manhkhiemhoang2-bit/xinmou-real-time-vision-tracking/mechanical/v10/V10_level_base_20261022/README_水平支撑说明.md

# 三轴云台 V10：桌面水平支撑修正

V9 装配中原项目留下的 battery holder 是 75 × 23 × 40 mm 的实心参考模型，已被标为“勿打印”。它在 V9 总装中低于桌面支撑面 12.625 mm，导致整机查看 STL 看起来由单独一块先接触桌面。V10 在原生 SolidWorks 总装中抑制此失效参考体，并重新导出整机查看 STL。

装齐底盖后，桌面接触面为底盖及左右两个后支脚，共三处。实际 STL 核对的最低高度均为 Z=25.000 mm；没有其他实体低于它们。底盖接触区约 71.8 × 60.8 mm，后脚各约 20 × 20 mm。三处可形成水平支撑；底盖不可省略。

7 种可打印 STL 共 10 件，与 V9 对应文件逐字节相同。已经打印 V9 的用户无需因本次修正重印。V10 修改的是总装中失效参考体的显示与整机预览。

外接电池和 HX1P35A 开发板未给出实测质量与最终安装点。等密度几何体积中心位于接触凸包内，距最近边约 58 mm；这仅是几何检查，不代表装入实物后的真实重心。装配后把底盖和两只后脚同时放在平整桌面上，检查摇晃；若打印面不平，修整三处接触面并复核电池位置。

保留 V9 的 MPU6050 双 M2 孔（中心距 16 mm、距俯仰平台前缘 10 mm）、走线孔及后部 HX1P35A 平台。
