manhkhiemhoang2-bit/xinmou-real-time-vision-tracking/hardware/td/ph1p35_isp/sim/_full6_check_判读说明.md

# `_full6_check.log` 判读说明（重要）

**看到日志末尾的 `结论：FAIL —— 1 条` 不要慌。RTL 没有问题，是 checker 的判据口径有瑕疵。**

## 那一条 FAIL 的真相

```
E M3的src行   断言 1,832,336   不符 34,306   FAIL
```

日志里紧挨着的两行已经把答案写明了：

```
反解 916168 个有效像素：多解/无解 34306，解出的行 != 期望行 0
候选 [彩色第 y-1 行（正确）]：不符        0 / 229042 拍   匹配（正确候选）
```

- **`解出的行 != 期望行 0`** —— 凡是能唯一反解出来的像素，**行号一个都没错**。
- 那 34,306 处全部是 **「多解/无解」**：测试图里有些像素值在相邻几行都出现，
  反解方法无法唯一确定它来自哪一行。**「猜不出来」不等于「猜错了」。**
- **正确候选（彩色第 y-1 行）0 失配 / 229,042 拍完美匹配**；
  另外三个错误候选（y 行、y-2 行、灰度行）全部 229,042 拍全错。
  ⇒ `rgb_row_delay_96` 在 320 深地址下工作**完全正确**。

首错那条 `(85880, 283, 270, 270)`：期望 270、实际也是 270，自己跟自己"不符"——就是这个毛病。

## 要改的地方（下次做）

E 组判据应把 **多解/无解记为 inconclusive**，只有「解出的行 != 期望行」才算 FAIL。改完即 PASS。

## 背景

这是**第三次**假警报来自 checker 而不是 RTL：
1. 「rgb_row_delay 每行丢最后 5 拍」→ checker 取样轴错位
2. 「TB 卡死」→ TB 消隐生成器死循环
3. 本条 → checker 把多解/无解当成错误

根源相同：这套全尺寸 checker 用「从数据反推期望值」的路子，
在规模大、数据有重复时容易产生歧义。**是验证工具的质量问题，不是设计问题。**
