manhkhiemhoang2-bit/xinmou-real-time-vision-tracking/hardware/td/ph1p35_isp/sim/_m7_report.md

# M7 区域填充接入 alg_top —— 集成报告（2026-09-18）

> 任务：把已验收的 `alg_region_fill_96`（v3.2）接成主流程第 8 档 **M7**，跑通集成回归。
> 本文是完整版；对话里给 ≤40 行的摘要。四个强制块在 ① / ② / ⑤ / ⑥。

---

## ① 结论一句话

M7 已接进 `alg_top` 三副本 + `.al`/`tcl` 登记，`check_sync.py` PASS；
小尺寸 **160×64 × 8 帧（f0..f7 = M0..M7）基线 355,753 条断言 0 失配**、
`vlog` **0 error 0 warning**、TB 自检 PASS；
**40 条真 RTL 变异全部被抓（含任务书点名的 5 类）**，无一条"dump 与基线相同"的空操作。
过程中实测定位到一个任务书没预料到的坑：**M3 的"窗口不可信拍"输出是未定义值，
填充模块的 3×3 膨胀会往左多吃一个像素把它吃进去**（1051 拍错位），
已在 M7 支路里用 `r_mask_d` 明确声明为黑并按同口径写进参考模型，失配归零。

---

## ② 证据路径

### 2.1 三副本 / 工程登记（`python check_sync.py` → VERDICT: PASS）

| 文件 | md5（三份相同） | 位置 |
|---|---|---|
| `alg_top.v` | `8bff2801fd77fc888c3332014023dbc6` | `src\` / `prj\_fullchip\alg\` / `prj\board\...\hdl_source\alg\` |
| `alg_region_fill_96.v` | `e3a92de0a23e5f3b25983b214a490511`（**未改动**，仍与验收时同 md5） | 同上三处 |

`.al` 新增 `alg/alg_region_fill_96.v`（CompileOrder 66，CRLF 保持：613 CRLF / 0 裸 LF）；
`prj\_fullchip\run_ab_alg.tcl` 的 `read_hdl` 清单加入 `alg/alg_region_fill_96.v`。
日志：`sim\_m7_check_sync.log`。落盘脚本：`sim\_m7_sync_files.py`（可重复执行）。

### 2.2 基线（`python run_m7_small.py` → rc=0）

* `vlog`：`Errors: 0, Warnings: 0`；`vsim` TB 自检 `in_beats=20480 out_beats=20480
  out_tlast=512 out_tuser=8 → RESULT=PASS`。
* dump：`sim\dump_m7_small.txt`（3,258,026 B = 31,434 拍）md5 `1106745dbc611a6ffad54aad3ec6f2e3`。
* 判据表（`sim\_m7_check.log`，**没有任何一条是 0 次检查**）：

| 判据 | 断言 | 不符 | 判据 | 断言 | 不符 |
|---|---|---|---|---|---|
| A 逐档延迟（M7=8） | 114,782 | 0 | F X/Z 泄漏 | 20,481 | 0 |
| B 八档逐拍对金标准 | 20,480 | 0 | J 每行/每帧拍数 | 61,444 | 0 |
| C 掩蔽区=原图（M7 除外，见 M③） | 3,977 | 0 | K M0 直通=LAT | 2,560 | 0 |
| D 档位锁存 | 20,488 | 0 | G bbox（按档选族） | 21 | 0 |
| E M3 的 src 行 | 19,344 | 0 | L M6 对齐/拍数/非空 | 5,124 | 0 |
| I 行/帧消隐工况 | 20,481 | 0 | **M M7 对齐/掩蔽/阈值/非空** | **5,129** | **0** |
| H 激励自检 | 61,442 | 0 | 合计 | **355,753** | **0** |

* M7 帧（f7，按键路径切进来的）：前景 **7,801 像素（76.2%）**、掩蔽区白 **0**、
  "阈值化 vs Sobel edge 掩码"不符 **0**、裸填充/带掩蔽填充差异 **177** ⇒ 判据 M 五门禁全非空。

### 2.3 变异（`python mutate_alg_top_full.py --size 160x64` → 40/40 PASS，244 s）

任务书点名的 5 类 + 本次定位到的坑，全部**实测 dump 与基线不同**（脚本逐字节比，无一条空操作）：

| 变异 | dump | 报红判据 | 结果 |
|---|---|---|---|
| M7 阈值 128→**255**（三字节全 0xFF，填不出东西） | 与基线不同 | B(2265) | 抓住 |
| M7 阈值 128→**8**（大片误判成白，近似全屏填满） | 与基线不同 | B(395) | 抓住 |
| M7 填充模块改吃**二值化支路** `w_b_dat`（实心图） | 与基线不同 | B(774) | 抓住 |
| M7 吃**未阈值化**的提亮彩图 `w_s_dat` | 与基线不同 | B(2265) | 抓住 |
| **按键循环上限只到 M6**（M7 永远切不到） | 与基线不同 | A(3074),**B(2560)**,**D(2560)**,M(194) | 抓住 |
| **输出 mux 漏掉 M7 一支**（回落 default 直通） | 与基线不同 | A(3074),**B(2560)**,M(194) | 抓住 |
| **档位常量 M7 写成 3'd6**（撞 MODE_MOTION） | 与基线不同 | A(3074),B(2560),**D(2560)**,M(194) | 抓住 |
| M7 输入不与 `r_mask_d` 相与（第 0 拍未定义值漏进膨胀） | 与基线不同 | B(1060) | 抓住 |
| 切进 M7 不提前 1 拍换档（边界多吐 1 拍） | 与基线不同 | A(3),B(1268),F(1),J(128),M(128),H(1) | 抓住 |
| M7 也叠顶层掩蔽（掩蔽区整体挪 3 拍） | 与基线不同 | B(257) | 抓住 |
| （原有 30 条 M5/M6/窗口/掩蔽/延迟…） | — | — | 30/30 抓住 |

改期望值那一半：`check_alg_top_full.py --selftest`（小尺寸）**28/28 抓住**（含 6 条 M7 口径变异）。
⚠ 其中 6 条 M7 口径变异带 `"_m7": True`，在**没有 M7 帧的 1280×720 时序里会被自动筛掉**
（不筛就是空操作 = 假"漏掉"，会让你的全尺寸 `--selftest` 变红）。

### 2.4 阈值选值的**实测**依据（`sim\_m7_thresh_probe.py`）

口径（三处写死同一份：`alg_top.v` §5d / `gen_stim_top_full.RF_TH` / 本报告）：
**白 ⟺ 三字节都 ≥ `RF_TH`（默认 128）**，其余一律黑。

| 几何 | 非边缘像素 min(R,G,B) 最大 | 边缘像素 min(R,G,B) 最小 | T=121..128 | T=8 | T=129 | T=255 |
|---|---|---|---|---|---|---|
| 160×64（帧 0..2） | 12 | 128 | **与 edge 掩码 0 失配** | 10,719 错 | 3,049 错 | 7,757 错（前景 0） |
| 1280×720（帧 0） | 120 | 128 | **0 失配**（163,777 前景） | — | 28,575 错 | 前景 0 |

* **128 = "不漏边缘"的最大阈值**：提亮后 `out_min = min(min(src)+K, 255) ≥ K = 128` 恒成立
  ⇒ 阈值 ≤ 128 时真边缘一个不漏；129 就漏 28,575 个。
* 非边缘像素 `out = src` 原样，实测 min 通道 ≤ 120 < 128 ⇒ 128 时不误判。
* 于是"三字节都 ≥ 128"在**本套激励**上逐像素等价于 Sobel edge 掩码（8 帧全部 0 失配，
  判据 M④ 每次跑都复验这一条）。
* `"三字节全 0xFF"`（254/255 口径）实测前景 **0** —— 这就是任务书说的"填不出东西"。

---

## ③ 集成的四处改动（都在 `alg_top.v`，M7 支路，未动任何已验收模块）

1. **档位**：`localparam MODE_REGIONFILL = 3'd7`；按键循环上限 `MODE_MOTION → MODE_REGIONFILL`；
   mux 加一支（数据+控制都取 `u_rf` 自己的）；`O_mode` 因此能出 7（判据 D：f7=[7]）。
2. **输入源**：`M3 的边缘流 → 硬阈值（`RF_TH`，见 2.4）→ u_rf`。
   阈值级是**纯组合**、不占延迟 ⇒ u_rf 的"延迟 3 拍"原样成立（累计 **4+3=7**）。
   输入还**与 `r_mask_d` 相与**（理由见 ④，这是本次唯一的非预期发现）。
3. **延迟**：M7 = **8 拍**（7 + 本级输出寄存器），M0..M6 仍是冻结的 5 拍。
   填充模块吃边缘、边缘只有 M3 那条支路有（已在延迟 4），4+3=7 是物理下限 —
   ⇒ M7 只能是"逐档延迟"，判据 A 因此改成**逐帧**判（M7 帧 8 拍、其余 5 拍）。
4. **掩蔽**：M7 档**不叠顶层掩蔽**（`w_masked_dat` 对 M7 直通）。
   两条理由：(a) u_rf 自带同口径掩蔽（前 3 行 + 每行第 0 拍）；(b) 顶层掩蔽对齐在延迟 4 拍，
   与 M7 的 7 拍不同拍，硬叠会把掩蔽区整体挪 3 拍（每行 12 像素）。
   ⇒ M7 帧掩蔽区输出**黑**，其余档位仍是"掩蔽期输出原图"。判据 M③ 单独钉死这条语义。

---

## ④ 本次唯一的非预期发现（已修，留作回归）

**现象**：接入后 M7 帧 1,051 拍不符，失配行恰好是 `8..15 / 24..31 / 40..47 / 56..63`。

**定位链**（四步，每步都有独立证据）：

1. 探针 TB（`sim\_m7dbg\tb_m7_probe.v`，**调试用，不进交付判据**）打出 u_rf 的输入流/膨胀/inside；
   `sim\_m7_probe_cmp.py` 按拍序对拍 → **填充模块的输入流本身就有 62 拍与参考不同**。
2. 62 拍全是**每行的第 0 拍**：RTL 给 `####`（4 个像素全算边缘），金标准给 `#...`。
   根因 = `alg_sobel_96` 的窗口在"窗口不可信拍"上**横跨行/帧边界**，输出的是**未定义值**；
   M3 档位上看不出来，因为顶层掩蔽在这些拍上把结果换成了原图。
3. 那 62 拍被填充模块自己的掩蔽挡住了（第 0 拍输出黑）——**但 3×3 膨胀会往左多吃一个像素**：
   第 1 拍（列 4..7）的膨胀窗口含列 3，正是第 0 拍的未定义值 ⇒ 每行第 4 列冒出一个假边缘
   ⇒ 填充的 inside 翻转位置整体错位 ⇒ 1,051 拍错。
4. 反证：把 **RTL 实测的输入流**（含那 62 拍）喂给参考填充模型 → 与 RTL 输出 **0/2560 拍不符**
   ⇒ 填充模块本身完全正确，问题 100% 在"喂进去的流没定义"。`sim\_m7_dbg_frame.py` /
   `_m7_dbg_inside.py` / `_m7_probe_cmp.py` 是这一段的证据脚本。

**修法**：M7 支路的阈值输出再与 `r_mask_d`（就是顶层那套、对齐在延迟 4 拍的窗口可信信号）相与，
把这些拍**明确声明为黑**；参考模型同口径（`m7_input_mask()`）。
**回归钉死**：变异 `M7 输入不与 r_mask_d 相与` → B(1060) 报红。

⚠ **另一条路（本次没走，留给你定）**：把 `win3x3_96` 在第 0 拍的左邻补零，
让 M3 流**处处有定义**（与金标准完全一致），那样 M7 支路就不需要这一层掩蔽。
代价是要动已验收模块 + 3 副本 + 它自己的判据；本次按"最小改动、不碰已验收模块"处理。

---

## ⑤ 不确定 / 没验证 / 觉得可疑

1. **没跑 1280×720**（按任务书 §五.3）。所以"M7 在真实分辨率下也对"**没有被本轮的集成仿真验证**；
   已验证的是 (a) 填充模块自己在 1280×720×3 帧上 0 失配，(b) 本轮的接口/对齐/掩蔽/阈值口径。
   ⚠ 有一处**只在小尺寸验过、全尺寸没验**：进 M7 时提前 1 拍换档依赖"帧首前 ≥3 拍无有效数据"
   （本链路帧消隐 120 拍，行消隐 20 拍）。判据 I 把这条工况钉死在激励里，但**换别的激励要复核**。
2. **M3 第 0 拍/前 2 行的输出是未定义值**这件事，我是用"探针 + 参考对照"定的，
   没有翻官方例程确认；我把它当"接口未定义"处理（声明为黑），
   而不是"RTL 错了"——依据是模块契约里这些拍本来就标着"窗口不可信"。
3. **判据 A/B/C/J 都改成"逐档"了**：A 用逐拍延迟表、C 把 M7 帧排除（改由判据 M 覆盖）、
   L/M 的"输出拍位置"改成按帧比。这是**口径扩展不是放宽**（每条仍逐像素/逐拍要求相等，
   而且新增了 6 条 M7 口径的期望值变异与 11 条 RTL 变异来钉）。但确实是本项目的判据结构变动，
   请你复核：特别是 `check_a` 的 `lat_of_beat()` 与 `check_c` 里 `~is7` 这两处。
4. **`ref_region_fill` 的 `barrier_mask` 是 2 行**（win3x3 口径），而填充模块内部是 `r_y>=3`。
   两者在 shift1 之后等价是模块验收时的实测结论，本轮**沿用了这个结论**（前 8 行实测吻合）；
   我没有重新推导它。
5. **TD 综合/面积没跑**（任务书禁止）。新增资源粗估：12 个 8 bit 比较器 + 1 个 AND（阈值级）
   + u_rf 自身（文档记 2 块 ERAM）。ERAM 预算 45/108 → 约 47。
6. **`sim\_m7dbg\` 下带 DUT 内部探针的 TB 只是调试件**，交付判据（`tb_alg_top_full.v` + checker）
   一个 DUT 内部量都没读 —— 抗循环论证纪律没破。
7. **小尺寸激励的档位表被改了**（见 ⑥.5），"7 帧跑"的老命令会退化成 f7 也是 M7 而不是 M6；
   若你要复跑旧的 M6 结论，请用 `--frames 7`（帧 0..6 仍是 M0..M6，f7 只影响第 8 帧）。

---

## ⑥ 与任务书不符 / 我认为任务书写错了的地方

1. **"加一级硬阈值就行"不够**：阈值之外**还必须**用窗口可信信号挡住未定义拍（见 ④）。
   任务书假设"M3 的信号要么是纯二值、要么是提亮图，二值化即可"，
   实际还有第三种情况：**窗口不可信拍上 M3 输出的是未定义值**，而填充的膨胀会跨拍吃它。
   这一条如果你只按任务书做，会得到 1,051 拍错且极难定位（失配行还是周期性出现的）。
2. **"M7 的输出比 M0/M1 晚（行位移 + 3 拍）"里的"行位移"要分开算**：
   相对**原图**，M7 一共下移 **2 行**（M3 自己的 1 行 + 填充模块契约的 1 行），
   相对 **M0/M1 的输出帧**才是 1 行；拍延迟才是 +3。任务书把两者写在一起，
   按字面理解会做成"shift1"而不是"shift2"（本报告的判据都用 shift2 = `_shift1` 两次）。
3. **"模块内部已经做了掩蔽（3 行 + 每行第 0 拍），所以 alg_top 里这一档不要再叠行掩蔽"**：
   我按"**M7 档整条顶层掩蔽都跳过**"实现（掩蔽区输出黑，不是原图）。
   如果你的本意只是"不要再往 u_rf 的输入上叠掩蔽"（保留顶层"掩蔽期输出原图"），
   那就需要再补一条延迟 7 拍的原图通路 + 一条延迟 7 拍的掩蔽（96×3 DFF + 3 DFF），
   并且掩蔽语义会和别的档位一致 —— 但**任务书这句话字面上是让我跳过**，我按字面做了。
4. **档位编号与项目文档冲突**：`doc_describe\分层实施计划_20260917.md` 与
   `osd_mixer.v` 第 5 节的注释都写 **M7 = 直方图均衡（HISTEQ）**，任务书把 M7 给了区域填充。
   OSD 只显示 "M7" 两个字符，硬件上不冲突；但**文档/注释现在与 RTL 不一致**，建议你统一。
5. **任务书点名要抓的变异"按键循环上限只到 M6"在小尺寸里原本是抓不到的**：
   旧的小尺寸档位表 `I_mode_set=1` 恒 1、逐帧强制指定档位 ⇒ **按键路径根本没被激励**，
   这条变异会是"dump 与基线逐字节相同"的空操作（= 无效变异）。
   我把小尺寸的**第 8 帧改成走按键路径**（前 7 帧仍用 `I_mode_sel`，帧 6 内按 7 下键 ⇒
   `r_mode_hold=7`）。这样才能真正抓到它（实测 B/D 各 2560 报红）。
   这是对测试框架的**语义扩展**，任务书没提，我按"变异必须可抓"的目标做了。
6. **`_shift1()` 只对"过窗口"的档位成立**：M5（颜色检测）与 M6（帧差）都没有整体位移，
   M7 是**两次** `_shift1`。任务书说"M2/M3/M4 都这么比"是对的，但别把它推广到全部档位。
7. **"全尺寸由我统一跑"的提醒**：你那套 12 帧时序里没有 M7 帧，所以
   (a) 判据 **M 与 L 都会是 0 次检查**（两条都会打警告说明覆盖在小尺寸；
   `L` 在本次改动之前就已经是 0 次，不是新问题）；
   (b) 若你要在 1280×720 下验证 M7，需要给那套表加一帧 M7（改 `MODE_SCHED` 与 TB 的档位表，
   两者必须同改，否则判据 D 会报）。
8. `run_full_algtop.ps1` / `run_l1_full.ps1` / `run_bubble.ps1` / `run_all_alg_top.ps1` 的
   编译清单都已加上 `alg_region_fill_96.v` —— **不加的话你的全尺寸跑会直接编译失败**
   （TB 例化了 alg_top，alg_top 例化了 u_rf）。
