manhkhiemhoang2-bit/xinmou-real-time-vision-tracking/hardware/td/ph1p35_isp/sim/_rf_report.md

# 区域填充（alg_region_fill_96）验证报告 —— **FAIL，未通过**

> 一句话：控制路径全绿、算法规则已按你的要求改对，但**逐像素比对仍然失败**
> （小尺寸 8 帧 2560 像素中 311 个失配）。**我没有交付一个可判 PASS 的模块**，
> 下面是完整、可复现的现状与我修掉的每一个真 bug。

---

## ① 结论一句话

`src\alg_region_fill_96.v` 的**接口/延迟/拍数守恒/值域全部正确**（TB 契约断言 4 项全 0 错），
你要求的两条算法改动（**上升沿判据**、**只吃轮廓图**）已实现并与 Python 参考写死同口径；
但**逐像素比对 FAIL**（311/2560 失配），根因是行缓存窗口抽头/行尾复位的时序，**未收敛**。

## ② 证据路径与实测数据

| 项 | 文件 | 状态 |
|---|---|---|
| RTL | `src\alg_region_fill_96.v` | v3.1，vlog **0 error / 0 warning** |
| 小尺寸 TB | `sim\tb_region_fill.v` | **TB-RESULT: PASS** |
| 真实分辨率 TB | `sim\tb_region_fill_hd.v` | 已同步 LAT=3，**本轮未重跑**（见 ④） |
| Python 参考 | `sim\ref_region_fill.py` | 上升沿判据已同步；`--selftest` **33 检查 0 错** |
| 判据 | `sim\check_region_fill.py` | **FAIL** |
| 激励 | `sim\gen_stim_region_fill.py` | 8 帧小图（含 2px/4px 承重用例）+ 3 帧 1280×720 |
| 几何探针 | `sim\tb_probe_win.v` + `sim\_probe_win_gen.py` | 用它**定死**了抽头是规整 3×3（Δy=−2/−1/0） |

### 小尺寸轮（32×10，8 帧，640 拍，含气泡）

| 断言 | 检查次数 | 失配 | 说明 |
|---|---|---|---|
| A10 输入回读一致 | 2561 | 0 | TB 实发序列 == stim 文件 |
| A1 拍数守恒 | 1 | 0 | 输入 640 / 输出 640 |
| A2 延迟 3 拍 | 705 | 0 | 实测 3 拍，逐拍平移 0 失配 |
| A3 tlast | 705 | 115 | 判据写法问题，见 ④.1 |
| A4 tuser | 705 | 16 | 同上 |
| A11 行结构 | 80 | 6 | 同上 |
| A8 输出值合法 | 2560 | 0 | 只有 FFFFFF/000000 |
| **A5 逐像素** | 2560 | **311** | **未过** |
| A6 逐帧+护栏 | 16 | 7 | 未过 |
| A7 掩蔽纪律 | 24 | 0 | 掩蔽区全黑；掩蔽确实改变 253 像素 |
| A9 内部填充电平 | 640 | 163 | 未过 |

TB 自带独立契约断言：`lat_err=0 last_err=0 user_err=0 valid_err=0 xz_or_illegal=0`，
`in_vld=640 == out_vld=640`。

## ③ 本次修掉的**真 bug**（都留了实测症状）

1. **`O_tdata` 根本没接填充结果**（接了 `r_src2` = 原样输入）。症状：A2/A8 照样全绿，
   只有逐像素比对暴露。修后失配 574 → 225。**这是"别只数拍数"的又一实例。**
2. **行尾状态复位早了一拍**：`r_tlast` 在行末拍**末尾**才装载，直接用它清零会把行末那拍
   自己的填充算成 0 ⇒ 每行**最右 4 个像素填不上**（实测：DUT 行 2 是 5..28，参考是 5..31，
   正好少最后 3 个）。修法：清零条件再打一拍（`r_clr`）。
3. **TB 自己的仿真竞争**：延迟断言写在 posedge 块里会拿"旧 O_*"比"新移位链"，误报 FAIL。
   改成 **negedge 比较**（必须在报告里留档，避免重踩）。
4. **`r_word` 被两个 always 重复驱动**、`r_pix0d` 因此悬空（改注释时留下的重复块）。
5. **左邻居必须走独立位移链**：本模块只存 4 bit/拍，读出链上取不到"第 r_x−1 组"，
   win3x3_96 那种"从 32bit 字节内部取左邻居"在这里不成立。

### 上升沿判据（你这次要求的改动）—— 已实现且有承重证据

- RTL §12/§13：`rise = e & ~prev`，4 级串行链，`prev` 与 `inside` 共用同一个清零分支。
- Python 参考已同步，注释写清"为什么不用奇偶规则"。
- **承重证据（Python 实测）**：2 像素宽闭合矩形，新规则填 **260** 像素、旧规则只填 **192**
  （内部空）⇒ 该用例确实能抓住"退回逐像素翻转"这条变异。

## ④ 不确定 / 没验证 / 觉得可疑（必读）

1. **A3/A4/A11 的失配我判断是判据写法问题、不是 RTL 问题**：TB 用独立 3 级移位链逐拍比对
   tlast/tuser **全 0 错**，而 Python 判据用的是"按有效拍平移 3 拍"的近似，与带气泡的实际拍距
   不一致。**但我没有把它改成 0 就被叫停，属于未验证。**
2. **A5 剩余的 311 个失配我没定位到根因。** 已知形貌（帧 0 逐行打印）：
   - **每行最右 4 个像素少填**：`y2 ref 5..31` / `dut 5..28`（行末那拍的填充被截断）；
   - **被掩蔽的第 0 拍反被填白**：`dut` 每行都是 `####.` 开头（列 0..3 白、列 4 黑），
     而参考是 `.....`（列 0..4 全黑）——**掩蔽区被填了**，说明 `w_fill*` 在 `w_win_valid=0`
     时仍有非零路径。这两条是同一个"行首/行尾 inside 边界"问题的两端。
   我修到"行末复位晚一拍"（`r_clr`）就停了，**没有再做第 5 次猜测式修改** ——
   按你的要求，下一步应该用逐拍探针表把 `e/rise/inside/r_clr` 与 Python 参考逐拍对齐，
   而不是继续改 RTL 猜。
3. **行位移约定：我用实测否掉了"整体晚一行"**：按"参考整体下移一行"比时失配 225→389（更差），
   而且 8 帧里只有 1 帧在"位移 0"下对得上。**所以至少对本模块，"win3x3_96 那样晚一行"不成立**
   （因为底行抽头取的是**本拍**输入）。这一条与你的建议相反，依据是实测数字。
4. **真实分辨率轮（1280×720×3 帧）本轮没重跑**；`dump_rf_hd.txt` 是旧 RTL 的产物，
   **不能作为 v3.1 的证据**。旧版本曾跑通 TB 契约（691200 拍，lat_err=0，9 秒）。
5. **没有变异测试脚本。** ≥5 个变异（含"退回逐像素翻转"）**一个都没做** —— 这是本轮最大的缺口。
6. **没跑 TD 综合**，`#eram` / `#dram lut` **未知**（按规则做了 1 bit/像素 + 读地址位宽对齐，
   但没有实测数字）。
7. **可疑**：`r_src2` 现在成了死寄存器（只写不读），综合会删掉；不影响功能，但应清理。

## ⑤ 与你给我的任务书不符 / 我觉得你写错了的地方

1. **"照抄 win3x3_96 的读地址领先 1 拍"在本模块不能照抄**：它每拍存 32 bit，左邻居能从
   读出数据的字节内部取；本模块为省 ERAM 只存 4 bit/拍，**链上取不到**第 r_x−1 组。
2. **"2 像素用例：改规则前必须失败"这一半我留了证据，"改完必须过"这一半没做到** ——
   因为行尾时序还有 bug（④.2），与上升沿规则无关。
3. **"行错位是既有约定、照 (A) 处理"这条我用实测否掉了**（④.3）。
4. **"至少一轮 1280×720"这条本轮没满足**（④.4）。
5. 我没有为了让判据变绿而放宽任何期望 —— 报告的就是 FAIL。

## ⑥ 第 5 次尝试（按你的判断做）—— **没做成，按约定停手，不再来第 6 次**

你的判断我复核了：**方向对**（这两端确实是"inside 属于哪一行"这一个问题）。
我按你说的做了**不改 RTL、先在模型里验**（`sim\_probe_inside.py`）：

```
clr_mode=tlast     -> 与 RTL dump 失配 278 拍
clr_mode=tlast_d   -> 与 RTL dump 失配 272 拍
clr_mode=rowstart  -> 与 RTL dump 失配 278 拍      ← 你建议的几何计数器口径
rowstart 模式 vs Python 参考：166/640 拍失配
   首错 cyc=18 r_x=1 r_y=2 e=[1,1,1,1] rise=[1,0,0,0] inside_in=0
        got=####   ref=....
```

**为什么停手**：三种清零口径的失配数几乎一样（272~278）⇒ **主要误差不在清零口径上**。
而且我随后发现**模型本身有一个未修正的拍号偏移**：

> 模型里 `r_x` 在 cycle 18 已经是 1（第 2 行第 1 拍），而真 dump 在 cycle 18 处理的是
> **第 2 行第 0 拍** ⇒ 模型的 `r_x` 比 RTL **早一拍**。所以上表里"e=1111 vs ref=0000"
> 这类差异**有一部分是模型自己对不齐造成的，不能直接当成 RTL 的错**。

在这种前提下继续按模型结论改 RTL，就是第 6 次猜测式修改，按你的约定我不做。
**下面是你要的逐拍表**（模型输出，前 2 行 × 前 16 拍；列：cyc / r_x / r_y / e / rise / inside_in / fill）：

```
cyc r_x r_y  e     rise   inside_in  fill
  8   0   0  0000  0000   0          0000    <- 被掩蔽 (r_y<2)
  9   1   0  0000  0000   0          0000
 10   2   0  0000  0000   0          0000
 11   3   0  0000  0000   0          0000
 12   4   0  0000  0000   0          0000
 13   5   0  0000  0000   0          0000
 14   6   0  0000  0000   0          0000
 15   7   0  0000  0000   0          0000    <- 行末
 16   0   1  0000  0000   0          0000    <- 新行首拍
 17   1   1  0000  0000   0          0000
 18   1   2  1111  1000   0          1111    <- 模型已进第 2 行；RTL 同拍仍是第 2 行第 0 拍
 19   2   2  1111  0000   1          1111
 20   3   2  1111  0000   1          1111
 21   4   2  1111  0000   1          1111
 22   5   2  1111  0000   1          1111
 23   6   2  1111  0000   1          1111
```

**建议的下一步**（我不做，交给你定）：先把 `_probe_inside.py` 的 `r_x`/`x_grp` 对齐到 RTL
（锚点：真 dump 里第 2 行第 0 拍出现在 cycle 18），**模型与 RTL 逐拍 0 失配之后**再用它比参考 ——
否则模型给出的"与参考的差异"里混着模型自己的偏移。

---

## ⑦ 集成结论（可执行：两条 + 一条补充）

1. **只能吃轮廓图**：输入必须是边缘检测（Sobel）的输出。**绝不能接二值化的实心色块** ——
   实心图每行只有"整段白"，上升沿只在段首出现一次，`inside` 会从段首一路保持到行尾，整幅花掉。
2. **模块内不做任何阈值**：输入期望**纯二值**（每像素恰好 `24'hFFFFFF` 或 `24'h000000`）。
   **这个硬阈值由你在 `alg_top` 里定，我不替它定**；本模块只认"三字节全 0xFF = 白"。
3. 模块**不反压**（`O_tready = I_tready`）、**单时钟域**、无 DSP/乘法器/除法器/DDR/厂商 IP。

---

## ⑧ 本轮**没做**的事（缺口的显式清单）

- ❌ 变异测试（≥5 个，含"退回逐像素翻转""去掉行首清零"两条护栏）——**一个都没做**
- ❌ 真实 1280×720×3 帧轮（`dump_rf_hd.txt` 是旧 RTL 产物，不可当证据）
- ❌ TD 综合实测 `#eram` / `#dram lut`
- ❌ 小尺寸逐像素 0 失配（当前 311/2560）
