manhkhiemhoang2-bit/xinmou-real-time-vision-tracking/docs/交付范围.md

# 交付范围与版本依据

- TD：当前 ph1p35_isp 工程的板级 RTL、IP 源与配置、约束、LUT/ROM 初始化文件、公共源码、模块仿真和生成脚本。
- FD：当前 FDWork 中的 yuntai_mcu 应用与 MCU_fpga 配套平台，保留 BSP、驱动、链接脚本和工程配置。
- 机械：用户指定的 V10 原生总装目录完整复制，包含 1 个装配、12 个零件及原有预览、说明和许可。
- 实现结果：活动 syn_1 / phy_1 的已有烧录文件、资源与时序报告；MCU 已有编译产物单列保存。
- 验证：报告图 5 / 图 7 对应的 ModelSim 测试源码、脚本和已有波形。

未纳入：历史 bak 备份、TD 旧 R1-R6 下载目录、综合布局布线数据库、IDE 工作区缓存、重复仿真工作库、视频和个人提交表单。这些不属于本次工程复现所需输入。

TD / FD 工程原有绝对目录由 tools/prepare_workspace.py 在解压或克隆后更新；逻辑源码、固件算法、机械文件和烧录文件保持原内容。三个大型仿真激励经 gzip 无损压缩保存。

机械目录的原有 MANIFEST_SHA256.json 中，总装 SLDASM 的旧校验值与当前文件不同，其余条目相符。本次保留用户指定目录当前的总装文件和原始清单，总装当前校验值由仓库根目录 MANIFEST_SHA256.json 记录。仅根据校验值不能判断总装的修改原因，本次未重保存或修改 CAD 文件。
