manhkhiemhoang2-bit/xinmou-real-time-vision-tracking/mechanical/v10/V10_level_base_20261022/V10_支撑面俯视核对.png

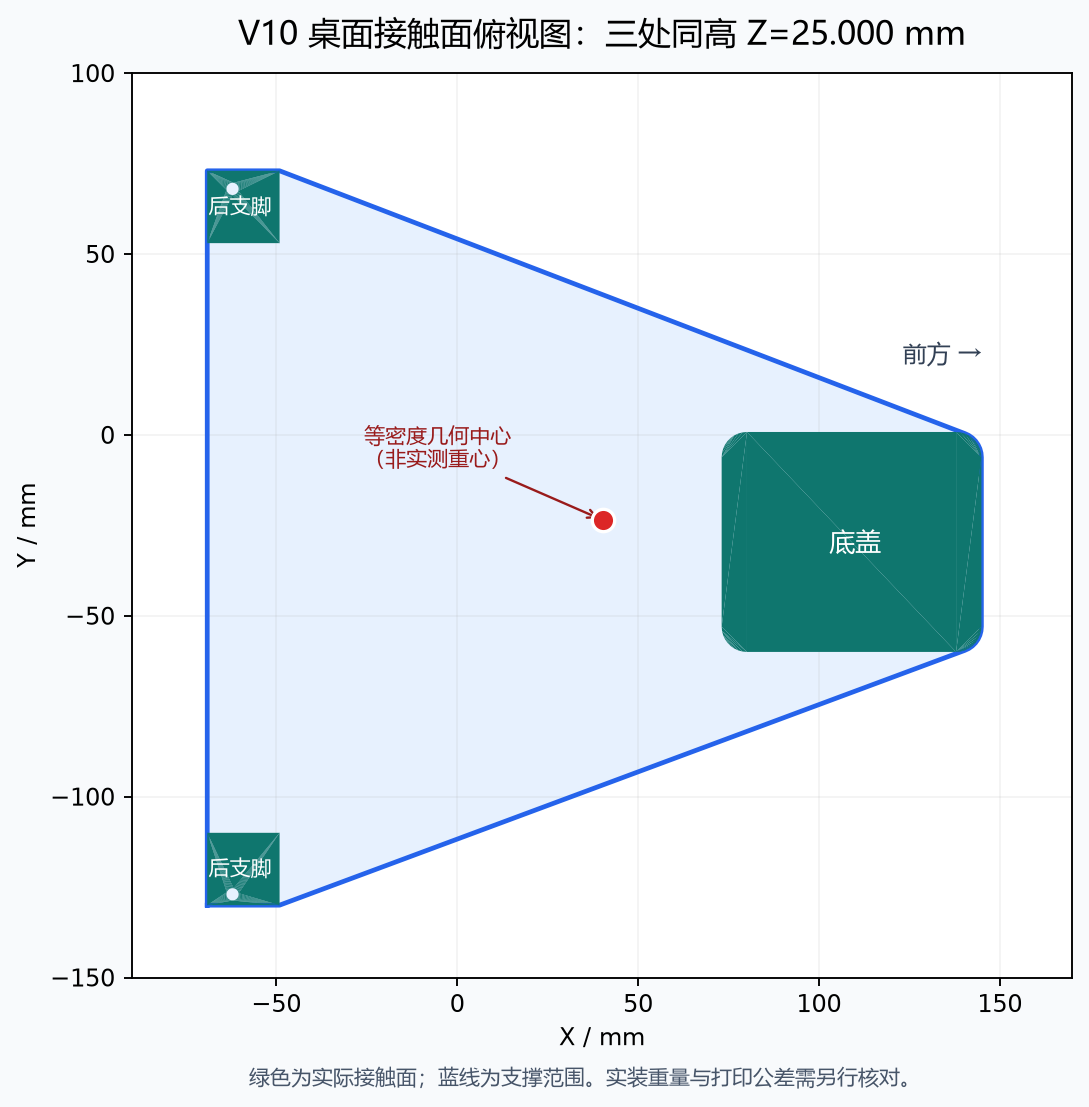
mechanical/v10/V10_level_base_20261022/V10_支撑面俯视核对.png
