manhkhiemhoang2-bit/xinmou-real-time-vision-tracking/mechanical/v10/V10_level_base_20261022/V10_V9_V5_V4_V3_V2_V1_Three_axis_gimbal.SLDASM

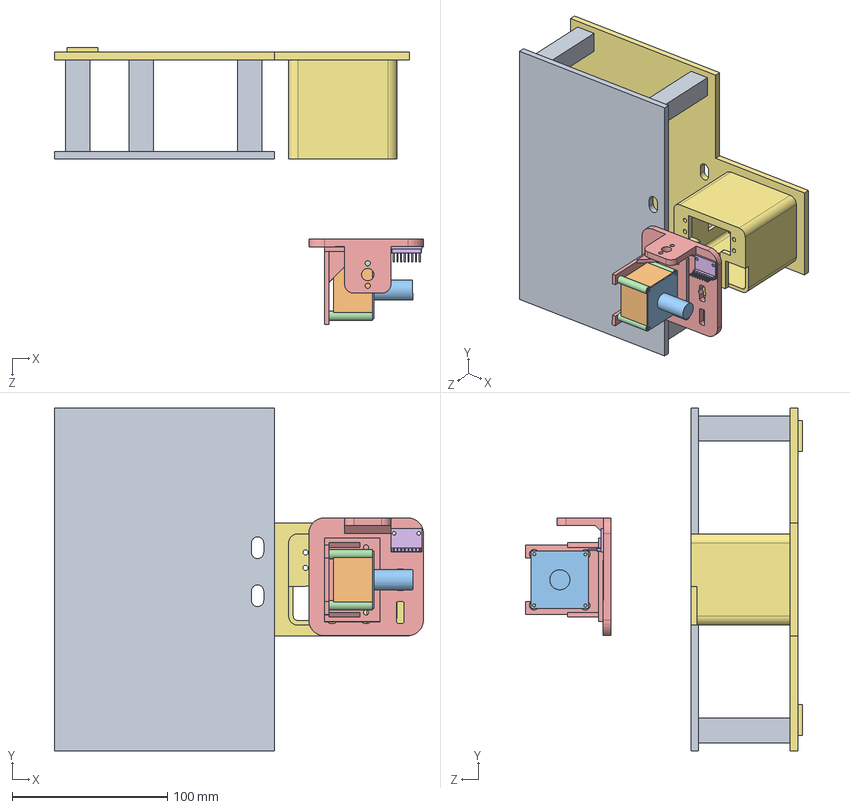
[picture p3: CAD file, 2026-11-03]
mechanical/v10/V10_level_base_20261022/V10_V9_V5_V4_V3_V2_V1_Three_axis_gimbal.SLDASM
238.0 x 221.0 x 178.7 mm
V10_V9_V5_V4_V3_V2_V1_Base 01 - Yaw servo
V10_V9_V5_V4_V3_V2_V1_MPU6050 model
V10_V9_V5_V4_V3_V2_V1_Top platform
V10_V9_V5_V4_V3_V2_Camera_spacer_28mm x 4
V10_V9_V5_V4_V3_V2_Camera_SC500CS_reference
V10_V9_V5_V4_V3_V2_Camera_rear25mm_reference
V10_V9_V5_V4_Rear_electronics_raised_deck
