manhkhiemhoang2-bit/xinmou-real-time-vision-tracking/mechanical/v10/V10_level_base_20261022/V10_V9_V5_V4_V3_V2_Camera_spacer_28mm.SLDPRT

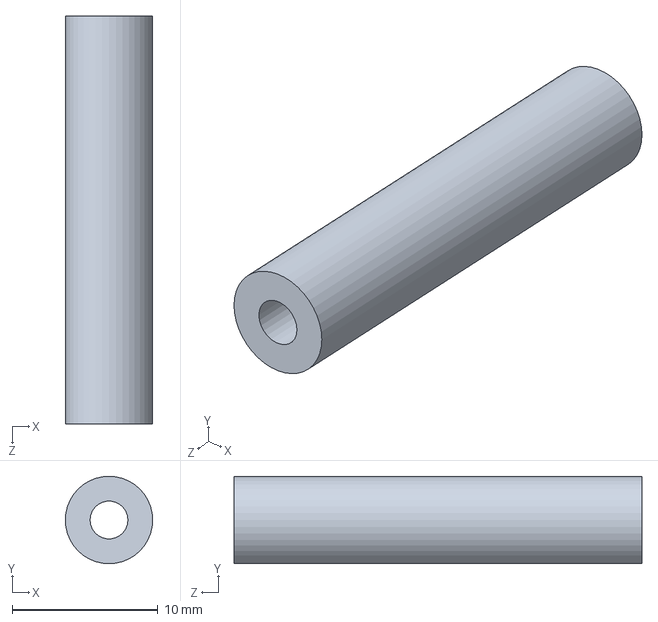
[picture p4: CAD file, 2026-11-03]
mechanical/v10/V10_level_base_20261022/V10_V9_V5_V4_V3_V2_Camera_spacer_28mm.SLDPRT
6.00 x 6.00 x 28.0 mm
