manhkhiemhoang2-bit/xinmou-real-time-vision-tracking/mechanical/v10/V10_level_base_20261022/V10_V9_V5_V4_V3_V2_Camera_SC500CS_reference.SLDPRT

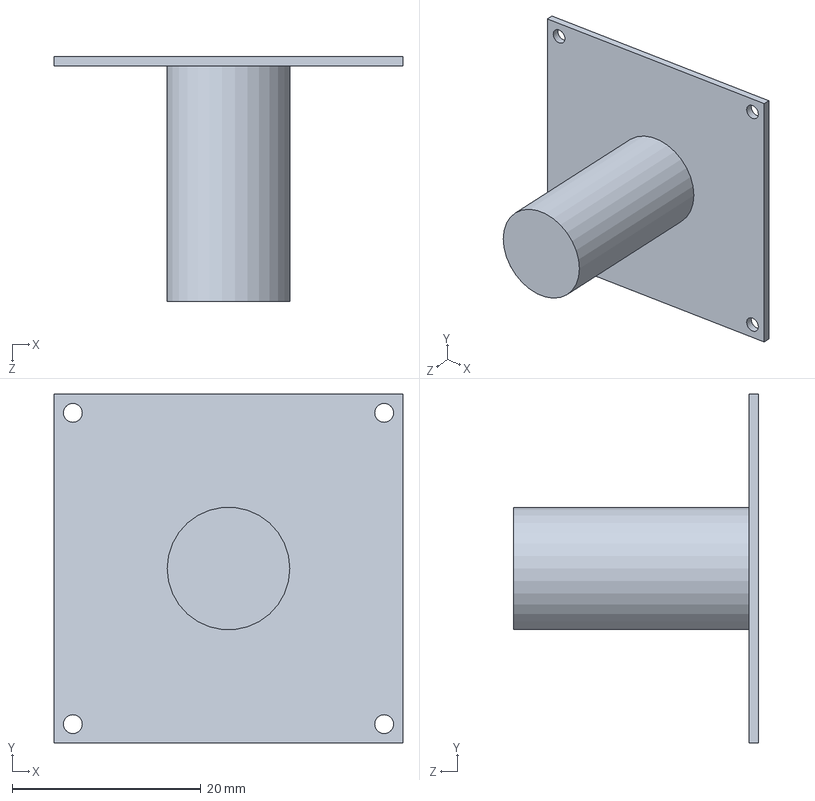
[picture p5: CAD file, 2026-11-03]
mechanical/v10/V10_level_base_20261022/V10_V9_V5_V4_V3_V2_Camera_SC500CS_reference.SLDPRT
37.0 x 37.0 x 26.0 mm
