manhkhiemhoang2-bit/xinmou-real-time-vision-tracking/mechanical/v10/V10_level_base_20261022/V10_V9_V5_V4_V3_V2_V1_MPU6050 model.SLDPRT

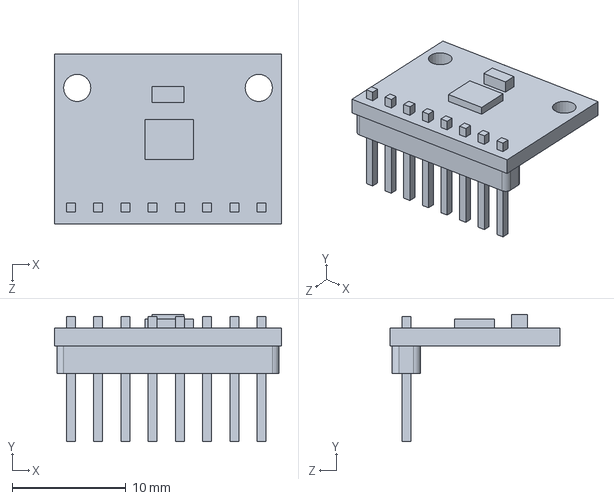
[picture p6: CAD file, 2026-11-03]
mechanical/v10/V10_level_base_20261022/V10_V9_V5_V4_V3_V2_V1_MPU6050 model.SLDPRT
20.0 x 11.2 x 15.0 mm
