manhkhiemhoang2-bit/xinmou-real-time-vision-tracking/mechanical/v10/V10_level_base_20261022/V10_V9_V5_V4_V3_V2_V1_Base 01 - Yaw servo.SLDPRT

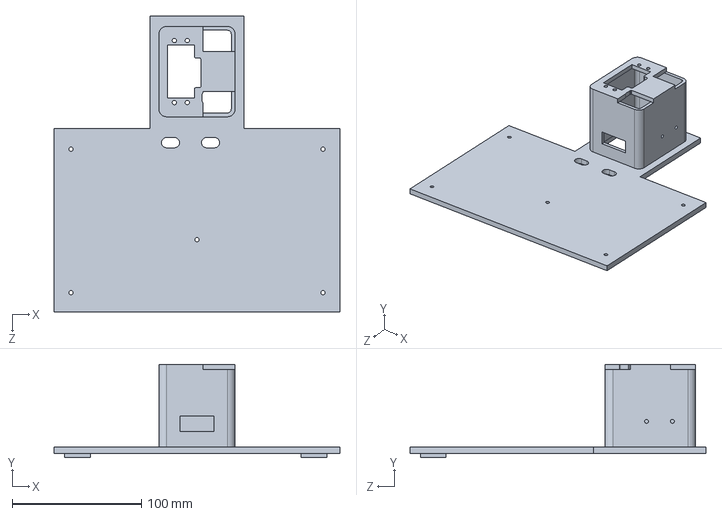
[picture p7: CAD file, 2026-11-03]
mechanical/v10/V10_level_base_20261022/V10_V9_V5_V4_V3_V2_V1_Base 01 - Yaw servo.SLDPRT
221.0 x 72.0 x 229.0 mm
