manhkhiemhoang2-bit/xinmou-real-time-vision-tracking/mechanical/v10/V10_level_base_20261022/V10_V9_V5_V4_Rear_electronics_raised_deck.SLDPRT

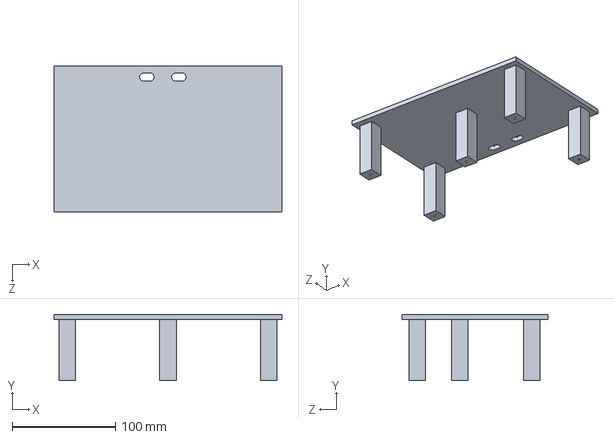
[picture p8: CAD file, 2026-11-03]
mechanical/v10/V10_level_base_20261022/V10_V9_V5_V4_Rear_electronics_raised_deck.SLDPRT
221.0 x 64.0 x 142.0 mm
