manhkhiemhoang2-bit/xinmou-real-time-vision-tracking/mechanical/v10/V10_level_base_20261022/V10_V9_V5_V4_V3_V2_V1_Top platform.SLDPRT

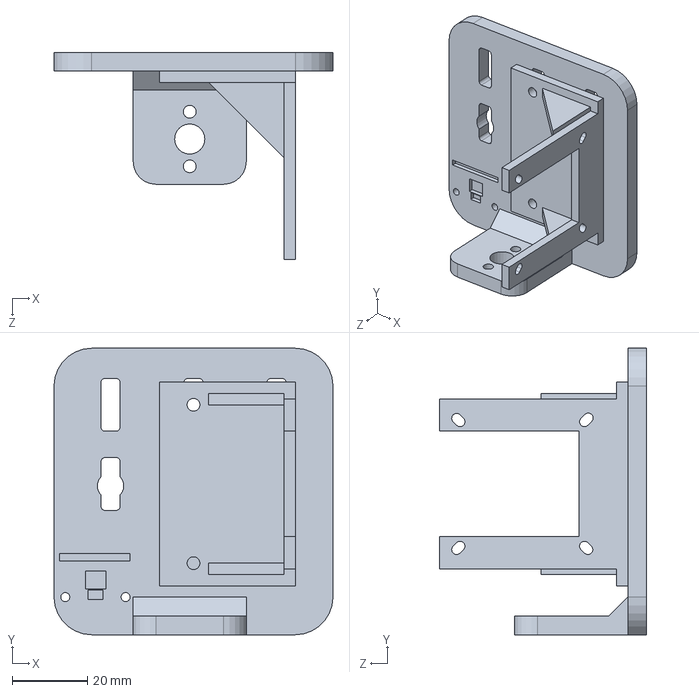
[picture p10: CAD file, 2026-11-03]
mechanical/v10/V10_level_base_20261022/V10_V9_V5_V4_V3_V2_V1_Top platform.SLDPRT
74.0 x 76.0 x 55.0 mm
