manhkhiemhoang2-bit/xinmou-real-time-vision-tracking/(list of files, cad)

Other CAD files:
mechanical/v10/V10_level_base_20261022/V10_V9_V5_V4_V3_V2_V1_Base 02 - Roll servo.SLDPRT
mechanical/v10/V10_level_base_20261022/V10_V9_V5_V4_V3_V2_V1_bottom cover.SLDPRT
mechanical/v10/V10_level_base_20261022/V10_V9_V5_V4_V3_V2_V1_battery holder.SLDPRT
mechanical/v10/V10_level_base_20261022/V10_V9_V5_V4_V3_V2_V1_Servo MG996R_r1.SLDPRT
mechanical/v10/V10_level_base_20261022/V10_V9_V5_V4_V3_V2_V1_Base 03 - Pitch servo.SLDPRT
