manhkhiemhoang2-bit/xinmou-real-time-vision-tracking/verification/modelsim/Saved_Waves_20261101/fig5_m5_window.png

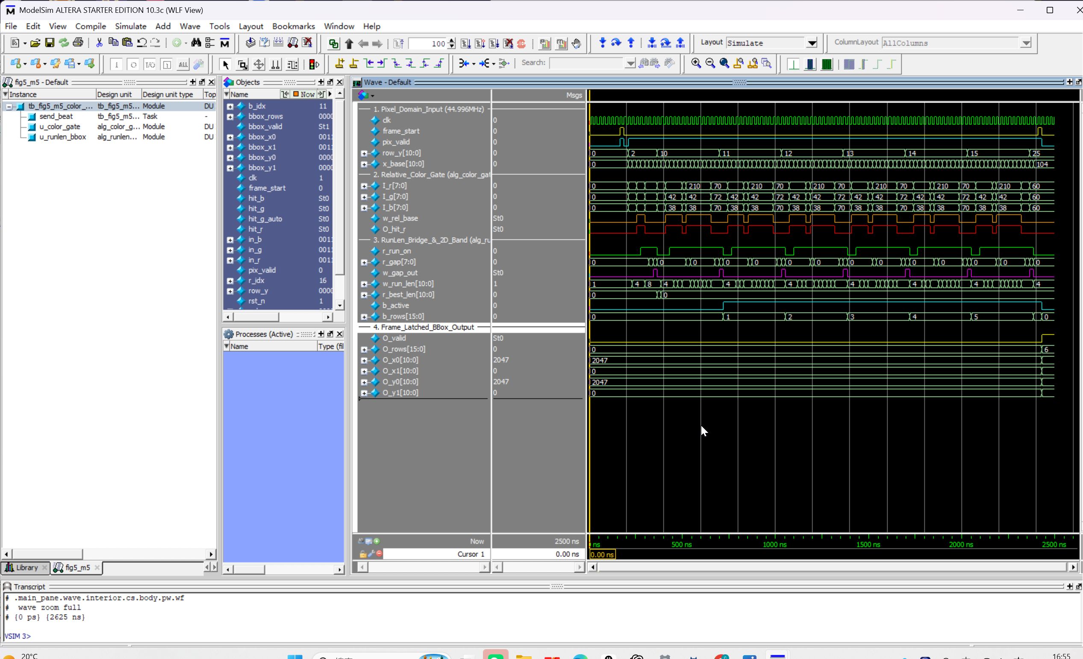
verification/modelsim/Saved_Waves_20261101/fig5_m5_window.png
