manhkhiemhoang2-bit/xinmou-real-time-vision-tracking/hardware/td/ph1p35_isp/sim/_rf_report_fix.md

# 区域填充 alg_region_fill_96 —— 交付版报告（v3.2 · 本轮收口）

> 一句话：探针把"斜切"从猜测变成实测；三处改动后
> **真实分辨率 1280×720×3 帧（276 万像素 / 1106 万次检查）0 失配 PASS**；
> **小尺寸 8 帧 2560 像素 311 → 0 失配 PASS**（含 1 个已定根、已点名的边界像素）；
> 7 条活变异全被抓（另有 1 条死逻辑变异标 VACUOUS，不计）。

---

## ① 结论一句话

v3.1 的 3×3 窗口**上/中两行整体左偏一组（4 列）**、两个左邻抽头取的不是左邻（探针实测）；
改掉横向对齐链 + 行首清零挂输出侧拍号 `r_x` + 掩蔽行门槛 2→3（配套"输出晚一行"约定）后：
`vlog` 0 error / TB 契约全绿 / **小尺寸 311 → 0**（含 1 个点名例外像素）/
**真实分辨率 276 万像素 0 失配 PASS**。判据已按约定（参考整体下移一行）对齐，
并把那 1 个边界像素钉成**坐标级点名例外**（任何别的偏差照样报红，自证 S4 专验这条）。

**本轮能收敛的两个原因（记一笔）**：
① **位平面扫描探针**把"斜切/横向错位"从猜测变成**实测坐标**，一次顶掉前面三次盲改；
② **逐拍模型做到 FIDELITY-OK**（对当前 RTL dump 13 字段 × 704 行逐行完全相同），
所以它的"预测 108 → 实测 108"与"四口径扫描"才有资格当决策依据
（它自己曾因"气泡时位移链照移"的建模错给出过错误结论，已修）。

---

## ② 证据路径与实测数据

### 2.1 探针（真 RTL，本轮唯一新信息入口）

| 项 | 路径 |
|---|---|
| 探针 TB | `sim\_probe_taps_rf.v`（**7 轮位平面扫描**；行缓存 1 bit/像素 ⇒ 坐标编码法必失效） |
| 跑法+还原 | `sim\_probe_taps_run.py`（`+k=0..6`） |
| 输出表 | `sim\_probe_taps_table.txt`（修后 = 规整 3×3） |

修前（v3.1，16×6，r_y=2 是第一行可信拍）：`top/mid` 采 4x−4..4x、`bot` 采 4x−1..4x+4 ⇒ **斜切**；
`top_m1=(1,11)`、`mid_m1=(1,15)` ⇒ 左邻抽头取到**另一行**的旧列。
修后同拍：三行全部 4x−1..4x+4、行 −2/−1/0 ⇒ **规整 3×3**。

### 2.2 RTL 改动（三处，均有证据；未动架构、未加行缓存）

| # | 位置 | 改法 | 依据 |
|---|---|---|---|
| 1 | §9 窗口抽头 | 上/中行"本组"取 `s1`、右邻取读口新值 `r_rdX`、**左邻取 `s2[0]`**（bit0；bit3 是列 4x−4）；删 r_bl2/r_bl3 | 探针坐标 |
| 2 | §13 填充状态机 | 删 `r_clr`；`w_row_end = (r_x == LAST_BEAT)` ⇒ 行末拍把 inside/prev 置 0 | 判据=输出侧拍号，与几何计数器同源 |
| 3 | §10 掩蔽 | `w_win_valid` 行门槛 2 → **3** | "输出晚一行"⇒掩蔽行数跟着挪 |

`src\alg_region_fill_96.v` md5 = `e3a92de0a23e5f3b25983b214a490511`（UTF-8 无 BOM / LF / 空格缩进）。

### 2.3 判定结果

| 轮次 | dump md5 | 检查次数 | 失配 | 结论 |
|---|---|---|---|---|
| **小尺寸 32×10×8 帧（含气泡）** | `a9980c2b0c65050ce0b9906f2ca142c6` | 10557 | **0**（另：点名例外 1 像素） | **PASS** |
| **真实分辨率 1280×720×3 帧** | `09b182abe3e98e7c635adb7575d9e3e8` | **11,061,464** | **0**（点名例外 0 像素） | **PASS** |

小尺寸轮：A5 = 0（点名例外 1）+ A6 = 0 + A9 = 0 + A1/A2/A3/A4/A7/A8/A10/A11 全 0；
HD 轮：A5 2,764,800 像素 0 失配、A2/A3/A4 各 691,229 次 0、A9 691,200 次 0。
历史轨迹：**311（v3.1）→ 108（第 1 处）→ 1（第 2/3 处 + 判据跟约定）→ 0（点名例外）**。

判据侧配套（**不是放宽**）：A6 反过来要求"shift0 必须对不上"（护栏）；
A9 探针采样从 `O_tvalid`（差 2 拍，一直报 163）改成 `r_vld1`；
A3/A4/A11 从"有效拍序号 +3 / dump 周期分块"改成逐周期 `O_x(t)==I_x(t−3)`、按有效拍分组。
`--selftest` 四条自证全 CAUGHT：S1 shift0 期望 / S2 口径错 / S3 探针口径错 /
**S4 例外表之外人为多造的 1 个失配照样报红**（证明例外表是"点名"不是"放宽"）。

### 2.4 变异表（`sim\_rf_mut_table.txt`）

| 变异 | dump | 结果 | 抓住它的断言 |
|---|---|---|---|
| M1 上升沿判据退回"每个白像素都翻转" | 与基线不同 `2adedccbe4c0` | 被抓 | A5,A6,A9 |
| M2 去掉行首清零（跨行残留） | 与基线不同 `dce53608508a` | 被抓 | A5,A6,A9 |
| M3 左邻 `s2[0]`→`s2[3]`（本轮修的横向链退化） | 与基线不同 `1878b180428d` | 被抓 | A5,A6,A9 |
| M4 `w_win_valid` 行门槛改回 2 | 与基线不同 `fd2b25240883` | 被抓 | A5,A6,A9 |
| M5 右邻取错一级（取 `s1` 而非读口新值）= v3.1 那种退化 | 与基线不同 `89c654d067b5` | 被抓 | A5,A6,A9 |
| M6 inside 4 像素并行算（输出等价、内部电平不同） | 与基线不同 `a28129548506` | 被抓 | A5,A6,A9 |
| **M5old 底行右邻恒 0** | **与基线逐字节相同** | **VACUOUS（死逻辑，不计入）** | —（测不出东西） |
| M7 判据侧去掉"晚一行"位移（用 shift0 期望比） | 判据侧变异 | 被抓 | A5,A6,A7 |

**有效变异 = 7/7 全被抓**（6 条 RTL + 1 条判据侧），每条 dump 都与基线字节不同；
`M5old` 标 **VACUOUS** 单列，**不算护栏、不计入成绩**。

---

## ③ 残留边界（1 个像素，已点名为例外 —— 是**已知边界**，不是未知缺陷）

**确切触发条件**：某拍的**最右像素**要用"**下一拍的首像素**"（`w_bot_4 = w_w0`，
与 `win3x3_96 §5` 的 `w_bot_4 = w_g0` 同法），而该拍之后 `I_tvalid` **连续拉低 ≥2 拍**
⇒ 该像素在"输出必须锁存"的那一拍之后才到 ⇒ latency 3 下**差一拍、取不到**。
实测样本：F3 孤立点在 (4,16)（正好落在拍边界），失配 `f3 y4 col15` 1 个像素；
连带 A9 探针 1 拍（f3 row4 grp4：ref_ins=1 / dut_ins=0 —— 错的 e3 把 inside 带错一拍，
像素仍对得上）。

**四条证据**：
1. 同激励下把前瞻恒 0（M5old），dump 与基线**逐字节相同** ⇒ 该前瞻"只在唯一一处起作用、
   而那一处本来就是气泡"，不是接线错；
2. 保真模型四口径扫描（气泡 1/2/3 拍 × 前瞻可得性）：2 拍下 现在=1 / +1=1 / **+2=0** / 上界=0
   ⇒ 唯一失配就是"前瞻拿不到"；要 0 必须允许**等 2 拍**，而 latency 3 最多等 **1 拍**；
3. **真 RTL 实测 BUB_SKIP=1（行中连续停 1 拍）→ TB PASS、10500 次检查 0 失配**
   ⇒ ≤1 拍完全正确，只有 ≥2 拍才触发；
4. 模型对当前 RTL dump **13 字段 × 704 行逐行相同（FIDELITY-OK）**。

**为什么真实链路大概率不触发**：本项目停顿来源是行/帧消隐，都发生在**行边界**，
而模块的行计数器本身被 `I_tvalid` 门控 ⇒ 行中不会出现连续 ≥2 拍空洞。
**需要在 M7（`alg_top` 集成后）全尺寸回归里核**：若实际流出现行中 ≥2 拍停，
该像素会复现（届时按下面备选处理）。

**已评估的备选（你已拍板选 A）**：

| 方案 | 代价 | 结果 |
|---|---|---|
| **A 接受该边界 + 坐标级点名例外**（本轮采用） | 0 | 小尺寸 1 像素（已点名）/ HD 0 |
| B `O_tdata` 加气泡恢复旁路 mux（组合输出） | 96 个 2:1 mux + 装配组合路径直连输出引脚（alg 臂 WNS 仅 750 ps，不值得） | 0（仅模型口径，未实现） |
| C TB 连续气泡限到 ≤1 拍 | 改激励＝放宽测试（作为测试改动被否决；但"停拍长度"边界要如实写进契约） | 0（真 RTL 已实测） |
| D 加第 3 条行缓存 / 整行延迟 | 破 latency 3 + `alg_top` 对齐表重做 | 0 |

**建议契约**：`I_tvalid` **行中连续拉低 ≤1 拍**（行边界不受限）。

---

## ④ 集成结论（接 M7 / 对齐 `alg_top` 延迟表照这个用）

1. **行位移**：**输出拍 y 承载输入第 y−1 行的填充结果（整体晚一行）** —— 与 `win3x3_96.v`
   （r0/r1/r2 = y−2/y−1/y、中心 y−1）同口径，也与 `check_alg_top_full.py` 的 `_shift1()` 一致；
   `alg_top` 里本档位按"整体下移一行"对齐。
2. **掩蔽**：模块内掩蔽 **3 行**（= 参考 2 行 + 位移 1）+ 每行第 0 拍：
   `w_win_valid = (r_y >= 3) && (r_x != 0) && !r_tuser`。**下游不要再叠行掩蔽。**
3. **时序/协议**：O_tvalid/tlast/tuser/tdata 与 I_* 同拍、延迟 **3** 拍；`I_tready` 直通不反压。
4. **契约建议**：`I_tvalid` 行中连续拉低 **≤1 拍**（≥2 拍时 §③ 那个像素算不出来）。
5. **资源**：未跑 TD（本轮不做）；删掉 r_bl2/r_bl3 后本级只少不多，2 条行缓存不变。

---

## ⑤ 本轮**没做**的事（都是你那边接）

1. **TD 综合/面积/时序**：本轮按纪律不跑（ERAM/LUT 实测未知）。
2. **`alg_top` 集成 + M7 全尺寸回归**（含第 4 条契约的实测核对）。
3. 真实分辨率轮**没有气泡**（TB 设计如此）⇒ §③ 的边界在那条路径上**没有被激励**，
   不是"验证过了"。

---

## ⑥ 不确定 / 没验证 / 可疑

1. 保真模型只在本轮的激励/参数下做过保真证明（13 字段 × 704 行）；**换激励要重新证**。
   它曾经有建模错（气泡时位移链照移），已修 —— 当工具用，别当真理。
2. 方案 B（组合旁路 mux）**只在模型里验过**（"+2"口径 0 失配），未实现、未综合、未评时序。
3. A9 采样口径、A3/A4/A11 逐周期化都是**我改的判据**（依据：探针属第 1 级、
   TB 自带独立移位链本来就 0 错），但确实动了前任 checker 的三处写法，请复核。
4. 点名例外表是"根因级"的：钉住 `(3,4,15)` 像素 + `(3,4,4)` 那一拍的探针；
   S4 自证了表外偏差仍会报红，但**换激励后这张表必须重审**（理想是清空）。
5. 前任的 `_probe_inside.py` / `_probe_align.py` / `_dbg_rf_*.py` 是旧口径脚本
   （`_probe_inside.py` 有拍号偏移）；本轮结论**没有**依赖它们。

---

## ⑦ 与你任务书不符 / 我认为你写错了的地方

1. **"只修横向对齐链"不够**：`top_m1/mid_m1` 两个左邻抽头**压根不走行缓存链**
   （实测取到另一行的旧列）—— 这也解释了前任改读地址三种变体（657/630/602）为何消不掉。
2. **"清零口径不是主因（278/272/278 几乎一样）"只在旧抽头下成立**：
   修正抽头后它能 260→108，是必要条件之一。
3. **"整幅下移一行不成立"的排除前提不成立**（那次是在斜切 RTL 上测的）；你已作废该排除，一致。
4. **探针"只打头两行就够"不成立**：头两行 `wv=0`（被掩蔽）、e 恒 0，看不出东西；你已更正。
5. **"0 失配、1 个像素也不行"在现有约束下无人能做到**（证据见 §③ 四条）。
   最终按你拍板的 A 收口：**边界如实记录 + 坐标级点名例外 + 契约写清停拍约束**。
6. **"变异 ≥5 全抓"的计数口径**：死逻辑变异（改的是没人用的通路）**不算护栏** ——
   本轮把 `M5old_bot4_zero` 标 VACUOUS 单列，有效数按 **7/7** 报（6 RTL + 1 判据侧）。
