manhkhiemhoang2-bit/xinmou-real-time-vision-tracking/hardware/td/ph1p35_isp/prj/board/lab_ex3_osd/td_project/al_ip/PLLF6F1D0P0_0/PLLF6F1D0P0_0.v

/************************************************************\
**	Copyright (c) 2012-2025 Anlogic Inc.
**	All Right Reserved.
\************************************************************/
/************************************************************\
**	Build time: Oct 04 2026 21:52:43
**	TD version	:	6.2.168116
************************************************************/
///////////////////////////////////////////////////////////////////////////////
//	Input frequency:                50.000000000 MHz
//	Clock multiplication factor: 6
//	Clock division factor:       1
//	Clock information:
//		Clock name	| Frequency 	| Phase shift 
//		C0        	| 300.000000   MHz	    |  0.0000 DEG 
//		C1        	| 50.000000   MHz	    |  0.0000 DEG 
///////////////////////////////////////////////////////////////////////////////
`timescale 1 ns / 100 fs 

module PLLF6F1D0P0_0
(
  input                         refclk,
  output                        clk0_out,
  output                        clk1_out,
  output                        lock,
  input                         reset
);
  wire							  clk0_buf;
PH1P_LOGIC_BUFG bufg_feedback (
 .i(clk0_buf), 
 .o(clk0_out) 
 ); 

 






  ph1p_phy_pll_wrapper_5e6f3927e27b
  #(
      .FBKCLK("CLKC0_EXT"),
      .FBKCLK_INT("CLKC0_EXT"),
      .FIN("50.000000000"),
      .REFCLK_DIV(1),
      .FBCLK_DIV(6),
      .CLKC0_ENABLE("ENABLE"),
      .CLKC0_DIV(4),
      .CLKC0_CPHASE(3),
      .CLKC0_FPHASE(0),
      .CLKC0_FPHASE_RSTSEL(0),
      .CLKC0_DUTY50("ENABLE"),
      .CLKC0_DUTY_INT(2),
      .CLKC1_ENABLE("ENABLE"),
      .CLKC1_DIV(24),
      .CLKC1_CPHASE(23),
      .CLKC1_FPHASE(0),
      .CLKC1_FPHASE_RSTSEL(0),
      .CLKC1_DUTY50("ENABLE"),
      .CLKC1_DUTY_INT(12),
      .PLL_USR_RST("ENABLE"),
      .PLL_FEED_TYPE("EXTERNAL"),
      .PLL_FASTLOOP("ENABLE"),
      .LPF_RES(0),
      .LPF_CAP(5),
      .ICP_CUR(29),
      .PHASE_PATH_SEL(0),
      .DYN_PHASE_PATH_SEL("DISABLE"),
      .DYN_FPHASE_EN("DISABLE"),
      .PI_OUT_SEL("NORMAL"),
      .PI_FRAC_EN("DISABLE"),
      .CLKC0_PI_SHIFT_EN("DISABLE"),
      .FEEDBK_MODE("NORMAL"),
      .DYN_CPHASE_EN("DISABLE")
  )ph1p_phy_pll_wrapper_5e6f3927e27b_Inst
  (
      .clk2_en(1'b0),
      .clk2_out(),
      .clkb2_out(),
      .clk3_en(1'b0),
      .clk3_out(),
      .clkb3_out(),
      .clk4_en(1'b0),
      .clk4_out(),
      .clkb4_out(),
      .clk5_en(1'b0),
      .clk5_out(),
      .clkb5_out(),
      .clk6_en(1'b0),
      .clk6_out(),
      .clkb6_out(),
      .refclk(refclk),
      .drp_clk(1'b0),
      .drp_rstn(1'b1),
      .drp_sel(1'b0),
      .drp_rd(1'b0),
      .drp_wr(1'b0),
      .drp_addr(8'b00000000),
      .drp_wdata(8'b00000000),
      .drp_err(),
      .drp_rdy(),
      .drp_rdata(),
      .psclk(1'b0),
      .psclksel(3'b000),
      .psstep(1'b0),
      .psdown(1'b0),
      .cps_step(1'b0),
      .psdone(),
      .ssc_reset(1'b0),
	  .clkc_rst(2'b00),
      .pllpd(1'b0),
      .fbclk(clk0_out),
      .wakeup(1'b1),
      .refclk_rst(1'b0),
      .clk0_en(1'b1),
      .clkb0_out(),
      .clk0_out(clk0_buf),
      .clk1_en(1'b1),
      .clkb1_out(),
      .clk1_out(clk1_out),
      .lock(lock),
      .reset(reset)
  );
endmodule
