manhkhiemhoang2-bit/xinmou-real-time-vision-tracking/hardware/td/ph1p35_isp/prj/board/lab_ex3_osd/td_project/al_ip/RISCV_F6F1D1P0_0/RISCV_F6F1D1P0_0.v

/************************************************************\
**	Copyright (c) 2012-2025 Anlogic Inc.
**	All Right Reserved.
\************************************************************/
/************************************************************\
**	Build time: Oct 05 2026 12:34:19
**	TD version	:	6.2.168116
************************************************************/
`timescale 1ps/1ps 
module RISCV_F6F1D1P0_0
(
  output                        core_sysrst,
  input                         gpio0_in,
  output                        gpio0_out,
  output                        gpio0_dir,
  input                         gpio1_in,
  output                        gpio1_out,
  output                        gpio1_dir,
  input                         gpio2_in,
  output                        gpio2_out,
  output                        gpio2_dir,
  output                        uart0_tx,
  input                         uart0_rx,
  input                         i2c_sda_in,
  output                        i2c_sda_out,
  output                        i2c_sda_sel,
  input                         i2c_scl_in,
  output                        i2c_scl_out,
  output                        i2c_scl_sel,
  output                        ahb_clk,
  output  [1:0]                 htrans,
  output                        hwrite,
  output  [30:0]                haddr,
  output  [2:0]                 hsize,
  output  [2:0]                 hburst,
  output  [3:0]                 hprot,
  output                        hmastlock,
  output  [31:0]                hwdata,
  input   [31:0]                hrdata,
  input   [1:0]                 hresp,
  input                         hready,
  input                         apb_clk,
  input                         apb_rst,
  output  [19:0]                paddr,
  output                        psel,
  output                        penable,
  output                        pwrite,
  output  [31:0]                pwdata,
  output  [3:0]                 pstrobe,
  output  [2:0]                 pprot,
  input   [31:0]                prdata,
  input                         pready,
  input                         pslverr,
  input                         core_clk,
  input                         timer_clk,
  input                         core_reset,
  input                         por_reset,
  input                         nmi,
  input   [22:0]                clic_irq
);

  MCU_ff19749f9ec3
  #(
      .MCU_JTAG_SEL("0"),
      .MCU_RESET_VECTOR('h20E00000),
      .AHB_FREQ("150.0"),
      .MCU_DPLL_POST_DIV(4),
      .MCU_DPLL_BYPASS("DISABLE")
  )MCU_ff19749f9ec3_Inst
  (
      .core_sysrst(core_sysrst),
      .gpio0_in(gpio0_in),
      .gpio0_out(gpio0_out),
      .gpio0_dir(gpio0_dir),
      .gpio1_in(gpio1_in),
      .gpio1_out(gpio1_out),
      .gpio1_dir(gpio1_dir),
      .gpio2_in(gpio2_in),
      .gpio2_out(gpio2_out),
      .gpio2_dir(gpio2_dir),
      .uart0_tx(uart0_tx),
      .uart0_rx(uart0_rx),
      .i2c_sda_in(i2c_sda_in),
      .i2c_sda_out(i2c_sda_out),
      .i2c_sda_sel(i2c_sda_sel),
      .i2c_scl_in(i2c_scl_in),
      .i2c_scl_out(i2c_scl_out),
      .i2c_scl_sel(i2c_scl_sel),
      .ahb_clk(ahb_clk),
      .htrans(htrans),
      .hwrite(hwrite),
      .haddr(haddr),
      .hsize(hsize),
      .hburst(hburst),
      .hprot(hprot),
      .hmastlock(hmastlock),
      .hwdata(hwdata),
      .hrdata(hrdata),
      .hresp(hresp),
      .hready(hready),
      .apb_clk(apb_clk),
      .apb_rst(apb_rst),
      .paddr(paddr),
      .psel(psel),
      .penable(penable),
      .pwrite(pwrite),
      .pwdata(pwdata),
      .pstrobe(pstrobe),
      .pprot(pprot),
      .prdata(prdata),
      .pready(pready),
      .pslverr(pslverr),
      .core_clk(core_clk),
      .timer_clk(timer_clk),
      .core_reset(core_reset),
      .por_reset(por_reset),
      .nmi(nmi),
      .clic_irq(clic_irq)
  );
endmodule
