manhkhiemhoang2-bit/xinmou-real-time-vision-tracking/hardware/td/ph1p35_isp/prj/board/lab_ex3_osd/user_source/hdl_source/alg/my_charlib.v

// ============================================================================
// my_charlib.v
//   —— 点阵数据由 gen_osd_rom.py 生成（自研原创素材，**不复制**官方 ROM）
//   生成时间：2026-09-12 21:11:57（点阵内容与旧版逐 bit 相同，本次未改数据）
//   规格：字符 ROM 42 字 x 16x16 点阵
//   说明：每行 16 bit，bit[15] = 最左像素（MSB first）
//         '1' = 点亮（取前景色），'0' = 透明/背景
//
// ============================================================================
//  ★★ 2026-10-24 v1.1：组合 case → **同步读 ROM（片上 ERAM / 块 RAM）**
// ============================================================================
//  【为什么改】旧版是 672 条 case 的**组合**译码器（`always @(*) case({I_index,I_row})`）。
//    TD 综合实测 u_charlib 的 #lut = 3785
//    （camera_to_dsi_display_Runs\syn_1\camera_to_dsi_display_rtl.area），
//    是全设计最大的单块 LUT 消耗；而它驱动的 "r_info_x → O_tdata" 链约 20 级 LUT。
//    改成存储器后，这 3785 个 LUT 整体挪进 ERAM（预计 1 块：672x16 = 10752 bit，
//    按本工程实测的 ERAM 规模 2048x18/块，见 alg_logo_eram.v §一）。
//
//  【接口变化（唯一一处，别的都不变）】
//    · 新增 I_clk：ERAM 是同步读，"地址进 → **下一拍**数据出"（1 拍读延迟）。
//    · O_bits 由 output reg（组合）改称 output wire（同步）：**比 I_index/I_row 晚 1 拍**。
//    · I_index/I_row 的语义、点阵内容、bit[15] 最左 —— 全部不变。
//    ⚠ 调用方（osd_mixer）必须按"晚 1 拍"消费：ROM 返回的这一拍，
//      所有同拍的陪跑信号（像素/Logo/字内列基址/行区间/控制）也得一起再延 1 拍，
//      漏一个就是文字面错位。osd_mixer 的做法见它自己的 §11b（p2 寄存器组）。
//
//  【输出与旧版的等价性（逐 bit，不是"差不多"）】
//    · I_index 0..41：O_bits = char_rom[{index,row}]，数据与旧版 case 逐 bit 相同。
//    · I_index 42..255：旧版落 case 的 default = 16'h0000；
//      新版由 r_idx_ok 掩蔽成 16'h0000 ⇒ 也逐 bit 相同。
//    · 逐拍等价的实证：sim_charlib_ram\tb_osd_equiv.v 同时例化新旧 osd_mixer，
//      新版输出 = 旧版整体延迟 1 拍、其余逐 bit 相等（ALL PASS）。
//
//  【ERAM 推断要点（照抄 alg_logo_eram.v §四，别随手改）】
//    ① 读地址位宽必须**恰好** $clog2(深度) = 10 位；
//    ② 读数据寄存器 r_bits **直连**阵列，中间不许有任何运算；
//    ③ 阵列上**没有复位、没有初值寄存器**（初值只用 initial）；
//    ④ ram_style 同时给属性 (* rom_style = "block" *) 和 TD 自家注释
//       //synthesis ram_style = bram（与 alg_logo_eram.v 同款，TD 认这条）。
//    ⚠ 是否真的吃到 ERAM，**只能等 TD 综合**看 report_area 的 #eram / #dram lut；
//      仿真看不出这件事（ModelSim 把阵列当普通数组，行为一样）。
//
//  【已知限制】
//    1. 读出的是**整行** 16 bit（一拍 4 个像素共用同一行字模），使用方自己按列选位。
//    2. 字库内容不能在线改写（只读）；要改字体得改本文件的 initial 段。
//    3. 读延迟固定 1 拍，不可参数化。
// ============================================================================
`timescale 1ns / 1ps

module my_charlib #(
    parameter CHAR_W = 16,        // 点阵宽（bit/行）
    parameter CHAR_H = 16,        // 点阵高（行/字）
    parameter CHAR_N = 42         // 字库字数
)(
    input  wire        I_clk,     // v1.1 新增：同步读时钟
    input  wire [ 7:0] I_index,   // 字符索引（见下面 CHAR_* 索引表）
    input  wire [ 3:0] I_row,     // 行地址 0..15
    output wire [15:0] O_bits     // 该行点阵，bit[15] = 最左（比 I_index/I_row 晚 1 拍）
);

localparam MEM_DEPTH = CHAR_N * CHAR_H;      // 672 = 42 x 16
localparam AW        = $clog2(MEM_DEPTH);    // 10 —— 必须恰好 10 位（§四①）

// ---- 字符索引表（与生成本文件时的 CHARLIB_ORDER 完全一致）----
//   idx= 0  '0'  code=0x30      idx=21  'L'  code=0x4C
//   idx= 1  '1'  code=0x31      idx=22  'M'  code=0x4D
//   idx= 2  '2'  code=0x32      idx=23  'N'  code=0x4E
//   idx= 3  '3'  code=0x33      idx=24  'O'  code=0x4F
//   idx= 4  '4'  code=0x34      idx=25  'P'  code=0x50
//   idx= 5  '5'  code=0x35      idx=26  'Q'  code=0x51
//   idx= 6  '6'  code=0x36      idx=27  'R'  code=0x52
//   idx= 7  '7'  code=0x37      idx=28  'S'  code=0x53
//   idx= 8  '8'  code=0x38      idx=29  'T'  code=0x54
//   idx= 9  '9'  code=0x39      idx=30  'U'  code=0x55
//   idx=10  'A'  code=0x41      idx=31  'V'  code=0x56
//   idx=11  'B'  code=0x42      idx=32  'W'  code=0x57
//   idx=12  'C'  code=0x43      idx=33  'X'  code=0x58
//   idx=13  'D'  code=0x44      idx=34  'Y'  code=0x59
//   idx=14  'E'  code=0x45      idx=35  'Z'  code=0x5A
//   idx=15  'F'  code=0x46      idx=36  ':'  code=0x3A
//   idx=16  'G'  code=0x47      idx=37  '.'  code=0x2E
//   idx=17  'H'  code=0x48      idx=38  '/'  code=0x2F
//   idx=18  'I'  code=0x49      idx=39  'SPACE' code=0x20
//   idx=19  'J'  code=0x4A      idx=40  '安' code=0xA1A2
//   idx=20  'K'  code=0x4B      idx=41  '路' code=0xA1A3

//------------------------------------------------------------------------------
// 1. 存储器本体（只读 + initial 初值。**没有复位、没有初值寄存器**，§四③）
//    地址 = {index[5:0], row}，即 index*16 + row；index 0..41 ⇒ 0..671。
//------------------------------------------------------------------------------
(* rom_style = "block" *)
reg [15:0] char_rom [0:MEM_DEPTH-1];   //synthesis ram_style = bram

initial begin

    // ---- '0' (idx 0) ----
    char_rom[  0] = 16'h3FF0;
    char_rom[  1] = 16'h6018;
    char_rom[  2] = 16'h6018;
    char_rom[  3] = 16'h6018;
    char_rom[  4] = 16'h6018;
    char_rom[  5] = 16'h6018;
    char_rom[  6] = 16'h6018;
    char_rom[  7] = 16'h6018;
    char_rom[  8] = 16'h6018;
    char_rom[  9] = 16'h6018;
    char_rom[ 10] = 16'h6018;
    char_rom[ 11] = 16'h6018;
    char_rom[ 12] = 16'h6018;
    char_rom[ 13] = 16'h3FF0;
    char_rom[ 14] = 16'h0000;
    char_rom[ 15] = 16'h0000;

    // ---- '1' (idx 1) ----
    char_rom[ 16] = 16'h0300;
    char_rom[ 17] = 16'h0F00;
    char_rom[ 18] = 16'h3F00;
    char_rom[ 19] = 16'h0300;
    char_rom[ 20] = 16'h0300;
    char_rom[ 21] = 16'h0300;
    char_rom[ 22] = 16'h0300;
    char_rom[ 23] = 16'h0300;
    char_rom[ 24] = 16'h0300;
    char_rom[ 25] = 16'h0300;
    char_rom[ 26] = 16'h0300;
    char_rom[ 27] = 16'h0300;
    char_rom[ 28] = 16'h3FFC;
    char_rom[ 29] = 16'h3FFC;
    char_rom[ 30] = 16'h0000;
    char_rom[ 31] = 16'h0000;

    // ---- '2' (idx 2) ----
    char_rom[ 32] = 16'h3FF0;
    char_rom[ 33] = 16'h6018;
    char_rom[ 34] = 16'h000C;
    char_rom[ 35] = 16'h000C;
    char_rom[ 36] = 16'h0030;
    char_rom[ 37] = 16'h00C0;
    char_rom[ 38] = 16'h0300;
    char_rom[ 39] = 16'h0C00;
    char_rom[ 40] = 16'h3000;
    char_rom[ 41] = 16'h6000;
    char_rom[ 42] = 16'h6000;
    char_rom[ 43] = 16'h6000;
    char_rom[ 44] = 16'h7FFE;
    char_rom[ 45] = 16'h7FFE;
    char_rom[ 46] = 16'h0000;
    char_rom[ 47] = 16'h0000;

    // ---- '3' (idx 3) ----
    char_rom[ 48] = 16'h3FF0;
    char_rom[ 49] = 16'h6018;
    char_rom[ 50] = 16'h000C;
    char_rom[ 51] = 16'h000C;
    char_rom[ 52] = 16'h00F0;
    char_rom[ 53] = 16'h00F0;
    char_rom[ 54] = 16'h000C;
    char_rom[ 55] = 16'h000C;
    char_rom[ 56] = 16'h000C;
    char_rom[ 57] = 16'h000C;
    char_rom[ 58] = 16'h000C;
    char_rom[ 59] = 16'h6018;
    char_rom[ 60] = 16'h3FF0;
    char_rom[ 61] = 16'h0000;
    char_rom[ 62] = 16'h0000;
    char_rom[ 63] = 16'h0000;

    // ---- '4' (idx 4) ----
    char_rom[ 64] = 16'h00F0;
    char_rom[ 65] = 16'h03F0;
    char_rom[ 66] = 16'h0C30;
    char_rom[ 67] = 16'h3030;
    char_rom[ 68] = 16'h6030;
    char_rom[ 69] = 16'h6030;
    char_rom[ 70] = 16'h7FFE;
    char_rom[ 71] = 16'h7FFE;
    char_rom[ 72] = 16'h0030;
    char_rom[ 73] = 16'h0030;
    char_rom[ 74] = 16'h0030;
    char_rom[ 75] = 16'h0030;
    char_rom[ 76] = 16'h0030;
    char_rom[ 77] = 16'h0000;
    char_rom[ 78] = 16'h0000;
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
//------------------------------------------------------------------------------
wire [AW-1:0] w_rom_addr = {I_index[5:0], I_row};   // 10 位，恰好 $clog2(672)

reg [15:0] r_bits;
always @ (posedge I_clk) begin
    r_bits <= char_rom[w_rom_addr];
end

//------------------------------------------------------------------------------
// 3. 索引合法性掩蔽（= 旧版 case 的 default: O_bits = 16'h0000）
//    与 r_bits **同沿寄存** ⇒ 掩蔽与数据永远同拍，不会错位。
//    放在读寄存器之外（不是数据通路的一部分），所以不影响 ERAM 推断。
//------------------------------------------------------------------------------
reg r_idx_ok;

initial begin
    r_idx_ok = 1'b0;
end

always @ (posedge I_clk) begin
    r_idx_ok <= (I_index < CHAR_N);          // 0..41 ⇒ 1
end

assign O_bits = r_idx_ok ? r_bits : 16'h0000;

endmodule
