manhkhiemhoang2-bit/xinmou-real-time-vision-tracking/hardware/td/ph1p35_isp/prj/board/lab_ex3_osd/user_source/hdl_source/alg/my_logo_rom.v

// ============================================================================
// my_logo_rom.v  —— 「2017-2026 / 国赛十周年」两行大字 Logo
//   生成：2026-10-25 20:09（fix_addr.py）
//   规格：288x114，1bpp，前景 #154B96 / 背景透明
//
// ★★★ 【天坑记录：ROM 地址必须按 2 的幂对齐，不要用实际段数】★★★
//   本设计一拍处理 4 像素，ROM 地址写成 case({I_y[6:0], I_x[8:4]})。
//   段号占 5 位 ⇒ 该表达式的值 = I_y*32 + seg（每行占 32 个槽位）。
//   ✘ 曾经错写成标签 = y*18 + seg（按实际段数 18 算），导致整幅图数据错位、
//    上屏是一片乱码（现象：文字/左上角图标都清晰，只有本 logo 发糊）。
//   ✔ 正确：标签 = y*32 + seg。段数不是 2 的幂时，行间会有空槽（由 default 兜住），
//     这是 Verilog case 拼接地址的固有代价，不能省。
//
//   地址位宽 7 + 5 = 12 位；最大标签 = 113*32+17 = 3633
//   越界：(I_x<LOGO_W && I_y<LOGO_H) 判据 ⇒ O_hit=0（透明）
// ============================================================================
`timescale 1ns / 1ps

module my_logo_rom #(
    parameter LOGO_W = 288,
    parameter LOGO_H = 114,
    parameter SEG_W  = 16,
    parameter [23:0] COLOR_FG = 24'h154B96,
    parameter [23:0] COLOR_BG = 24'h000000
)(
    input      [10:0] I_x,
    input      [10:0] I_y,
    output reg        O_hit,
    output reg [23:0] O_color
);

localparam NSEG = 18;

reg [15:0] pix_seg;

always @(*) begin
    pix_seg = 16'h0000;
    case ({I_y[6:0], I_x[8:4]})
        12'd129  : pix_seg = 16'h0078;   // 行  4 段 1
        12'd131  : pix_seg = 16'h01F0;   // 行  4 段 3
        12'd133  : pix_seg = 16'h07C0;   // 行  4 段 5
        12'd139  : pix_seg = 16'h3C00;   // 行  4 段11
        12'd141  : pix_seg = 16'hF800;   // 行  4 段13
        12'd142  : pix_seg = 16'h0001;   // 行  4 段14
        12'd143  : pix_seg = 16'hE000;   // 行  4 段15
        12'd144  : pix_seg = 16'h0007;   // 行  4 段16
        12'd145  : pix_seg = 16'hC000;   // 行  4 段17
        12'd161  : pix_seg = 16'h07FF;   // 行  5 段 1
        12'd162  : pix_seg = 16'h8000;   // 行  5 段 2
        12'd163  : pix_seg = 16'h1FFE;   // 行  5 段 3
        12'd165  : pix_seg = 16'h1FE0;   // 行  5 段 5
        12'd166  : pix_seg = 16'h0FFF;   // 行  5 段 6
        12'd167  : pix_seg = 16'hFFF8;   // 行  5 段 7
        12'd170  : pix_seg = 16'h0003;   // 行  5 段10
        12'd171  : pix_seg = 16'hFFC0;   // 行  5 段11
        12'd172  : pix_seg = 16'h000F;   // 行  5 段12
        12'd173  : pix_seg = 16'hFF80;   // 行  5 段13
        12'd174  : pix_seg = 16'h001F;   // 行  5 段14
        12'd175  : pix_seg = 16'hFE00;   // 行  5 段15
        12'd176  : pix_seg = 16'h007F;   // 行  5 段16
        12'd177  : pix_seg = 16'hF800;   // 行  5 段17
        12'd193  : pix_seg = 16'h1FFF;   // 行  6 段 1
        12'd194  : pix_seg = 16'hC000;   // 行  6 段 2
        12'd195  : pix_seg = 16'h7FFF;   // 行  6 段 3
        12'd196  : pix_seg = 16'h8000;   // 行  6 段 4
        12'd197  : pix_seg = 16'h3FE0;   // 行  6 段 5
        12'd198  : pix_seg = 16'h1FFF;   // 行  6 段 6
        12'd199  : pix_seg = 16'hFFF8;   // 行  6 段 7
        12'd202  : pix_seg = 16'h000F;   // 行  6 段10
        12'd203  : pix_seg = 16'hFFE0;   // 行  6 段11
        12'd204  : pix_seg = 16'h003F;   // 行  6 段12
        12'd205  : pix_seg = 16'hFFC0;   // 行  6 段13
        12'd206  : pix_seg = 16'h007F;   // 行  6 段14
        12'd207  : pix_seg = 16'hFF00;   // 行  6 段15
        12'd208  : pix_seg = 16'h01FF;   // 行  6 段16
        12'd209  : pix_seg = 16'hFE00;   // 行  6 段17
        12'd225  : pix_seg = 16'h3FFF;   // 行  7 段 1
        12'd226  : pix_seg = 16'hF000;   // 行  7 段 2
        12'd227  : pix_seg = 16'hFFFF;   // 行  7 段 3
        12'd228  : pix_seg = 16'hC000;   // 行  7 段 4
        12'd229  : pix_seg = 16'hFFE0;   // 行  7 段 5
        12'd230  : pix_seg = 16'h1FFF;   // 行  7 段 6
        12'd231  : pix_seg = 16'hFFF8;   // 行  7 段 7
        12'd234  : pix_seg = 16'h001F;   // 行  7 段10
        12'd235  : pix_seg = 16'hFFF8;   // 行  7 段11
        12'd236  : pix_seg = 16'h007F;   // 行  7 段12
        12'd237  : pix_seg = 16'hFFE0;   // 行  7 段13
        12'd238  : pix_seg = 16'h00FF;   // 行  7 段14
        12'd239  : pix_seg = 16'hFFC0;   // 行  7 段15
        12'd240  : pix_seg = 16'h03FF;   // 行  7 段16
        12'd241  : pix_seg = 16'hFF00;   // 行  7 段17
        12'd257  : pix_seg = 16'hFFFF;   // 行  8 段 1
        12'd258  : pix_seg = 16'hF801;   // 行  8 段 2
        12'd259  : pix_seg = 16'hFFFF;   // 行  8 段 3
        12'd260  : pix_seg = 16'hE003;   // 行  8 段 4
        12'd261  : pix_seg = 16'hFFE0;   // 行  8 段 5
        12'd262  : pix_seg = 16'h1FFF;   // 行  8 段 6
        12'd263  : pix_seg = 16'hFFF8;   // 行  8 段 7
        12'd266  : pix_seg = 16'h007F;   // 行  8 段10
        12'd267  : pix_seg = 16'hFFFC;   // 行  8 段11
        12'd268  : pix_seg = 16'h00FF;   // 行  8 段12
        12'd269  : pix_seg = 16'hFFF0;   // 行  8 段13
        12'd270  : pix_seg = 16'h03FF;   // 行  8 段14
        12'd271  : pix_seg = 16'hFFE0;   // 行  8 段15
        12'd272  : pix_seg = 16'h07FF;   // 行  8 段16
        12'd273  : pix_seg = 16'hFF80;   // 行  8 段17
        12'd289  : pix_seg = 16'hFFFF;   // 行  9 段 1
        12'd290  : pix_seg = 16'hF803;   // 行  9 段 2
        12'd291  : pix_seg = 16'hFFFF;   // 行  9 段 3
        12'd292  : pix_seg = 16'hF007;   // 行  9 段 4
        12'd293  : pix_seg = 16'hFFE0;   // 行  9 段 5
        12'd294  : pix_seg = 16'h1FFF;   // 行  9 段 6
        12'd295  : pix_seg = 16'hFFF8;   // 行  9 段 7
        12'd298  : pix_seg = 16'h007F;   // 行  9 段10
        12'd299  : pix_seg = 16'hFFFC;   // 行  9 段11
        12'd300  : pix_seg = 16'h01FF;   // 行  9 段12
        12'd301  : pix_seg = 16'hFFF8;   // 行  9 段13
        12'd302  : pix_seg = 16'h03FF;   // 行  9 段14
        12'd303  : pix_seg = 16'hFFE0;   // 行  9 段15
        12'd304  : pix_seg = 16'h0FFF;   // 行  9 段16
        12'd305  : pix_seg = 16'hFFC0;   // 行  9 段17
        12'd320  : pix_seg = 16'h0001;   // 行 10 段 0
        12'd321  : pix_seg = 16'hFC01;   // 行 10 段 1
        12'd322  : pix_seg = 16'hFC07;   // 行 10 段 2
        12'd323  : pix_seg = 16'hF007;   // 行 10 段 3
        12'd324  : pix_seg = 16'hF80F;   // 行 10 段 4
        12'd325  : pix_seg = 16'hFFE0;   // 行 10 段 5
        12'd326  : pix_seg = 16'h1F80;   // 行 10 段 6
        12'd327  : pix_seg = 16'h03F8;   // 行 10 段 7
        12'd330  : pix_seg = 16'h00FE;   // 行 10 段10
        12'd331  : pix_seg = 16'h00FE;   // 行 10 段11
        12'd332  : pix_seg = 16'h03F8;   // 行 10 段12
        12'd333  : pix_seg = 16'h03FC;   // 行 10 段13
        12'd334  : pix_seg = 16'h07F0;   // 行 10 段14
        12'd335  : pix_seg = 16'h07F0;   // 行 10 段15
        12'd336  : pix_seg = 16'h1FC0;   // 行 10 段16
        12'd337  : pix_seg = 16'h1FE0;   // 行 10 段17
        12'd352  : pix_seg = 16'h0003;   // 行 11 段 0
        12'd353  : pix_seg = 16'hF800;   // 行 11 段 1
        12'd354  : pix_seg = 16'hFC07;   // 行 11 段 2
        12'd355  : pix_seg = 16'hE001;   // 行 11 段 3
        12'd356  : pix_seg = 16'hF80F;   // 行 11 段 4
        12'd357  : pix_seg = 16'hE7E0;   // 行 11 段 5
        12'd358  : pix_seg = 16'h1F80;   // 行 11 段 6
        12'd359  : pix_seg = 16'h03F0;   // 行 11 段 7
        12'd362  : pix_seg = 16'h01FC;   // 行 11 段10
        12'd363  : pix_seg = 16'h007E;   // 行 11 段11
        12'd364  : pix_seg = 16'h03F0;   // 行 11 段12
        12'd365  : pix_seg = 16'h00FC;   // 行 11 段13
        12'd366  : pix_seg = 16'h0FE0;   // 行 11 段14
        12'd367  : pix_seg = 16'h03F0;   // 行 11 段15
        12'd368  : pix_seg = 16'h1F80;   // 行 11 段16
        12'd369  : pix_seg = 16'h0FE0;   // 行 11 段17
        12'd384  : pix_seg = 16'h0003;   // 行 12 段 0
        12'd385  : pix_seg = 16'hF000;   // 行 12 段 1
        12'd386  : pix_seg = 16'h7E0F;   // 行 12 段 2
        12'd387  : pix_seg = 16'hC001;   // 行 12 段 3
        12'd388  : pix_seg = 16'hF80F;   // 行 12 段 4
        12'd389  : pix_seg = 16'h87C0;   // 行 12 段 5
        12'd390  : pix_seg = 16'h1F80;   // 行 12 段 6
        12'd391  : pix_seg = 16'h03F0;   // 行 12 段 7
        12'd394  : pix_seg = 16'h01F8;   // 行 12 段10
        12'd395  : pix_seg = 16'h003F;   // 行 12 段11
        12'd396  : pix_seg = 16'h07E0;   // 行 12 段12
        12'd397  : pix_seg = 16'h00FC;   // 行 12 段13
        12'd398  : pix_seg = 16'h0FC0;   // 行 12 段14
        12'd399  : pix_seg = 16'h03F8;   // 行 12 段15
        12'd400  : pix_seg = 16'h3F00;   // 行 12 段16
        12'd401  : pix_seg = 16'h07E0;   // 行 12 段17
        12'd416  : pix_seg = 16'h0003;   // 行 13 段 0
        12'd417  : pix_seg = 16'hE000;   // 行 13 段 1
        12'd418  : pix_seg = 16'h7E0F;   // 行 13 段 2
        12'd419  : pix_seg = 16'hC001;   // 行 13 段 3
        12'd420  : pix_seg = 16'hF80E;   // 行 13 段 4
        12'd421  : pix_seg = 16'h07C0;   // 行 13 段 5
        12'd422  : pix_seg = 16'h1F80;   // 行 13 段 6
        12'd423  : pix_seg = 16'h07E0;   // 行 13 段 7
        12'd426  : pix_seg = 16'h01F0;   // 行 13 段10
        12'd427  : pix_seg = 16'h003F;   // 行 13 段11
        12'd428  : pix_seg = 16'h07E0;   // 行 13 段12
        12'd429  : pix_seg = 16'h007C;   // 行 13 段13
        12'd430  : pix_seg = 16'h1F80;   // 行 13 段14
        12'd431  : pix_seg = 16'h01F8;   // 行 13 段15
        12'd432  : pix_seg = 16'h3F00;   // 行 13 段16
        12'd433  : pix_seg = 16'h07E0;   // 行 13 段17
        12'd448  : pix_seg = 16'h0007;   // 行 14 段 0
        12'd449  : pix_seg = 16'hE000;   // 行 14 段 1
        12'd450  : pix_seg = 16'h7E0F;   // 行 14 段 2
        12'd451  : pix_seg = 16'hC000;   // 行 14 段 3
        12'd452  : pix_seg = 16'hF808;   // 行 14 段 4
        12'd453  : pix_seg = 16'h07C0;   // 行 14 段 5
        12'd455  : pix_seg = 16'h07E0;   // 行 14 段 7
        12'd458  : pix_seg = 16'h03F0;   // 行 14 段10
        12'd459  : pix_seg = 16'h003F;   // 行 14 段11
        12'd460  : pix_seg = 16'h07E0;   // 行 14 段12
        12'd461  : pix_seg = 16'h007C;   // 行 14 段13
        12'd462  : pix_seg = 16'h1F80;   // 行 14 段14
        12'd463  : pix_seg = 16'h01F8;   // 行 14 段15
        12'd464  : pix_seg = 16'h3F00;   // 行 14 段16
        12'd465  : pix_seg = 16'h07E0;   // 行 14 段17
        12'd480  : pix_seg = 16'h0007;   // 行 15 段 0
        12'd481  : pix_seg = 16'hE000;   // 行 15 段 1
        12'd482  : pix_seg = 16'h7E0F;   // 行 15 段 2
        12'd483  : pix_seg = 16'hC001;   // 行 15 段 3
        12'd484  : pix_seg = 16'hF800;   // 行 15 段 4
        12'd485  : pix_seg = 16'h0FC0;   // 行 15 段 5
        12'd487  : pix_seg = 16'h0FC0;   // 行 15 段 7
        12'd490  : pix_seg = 16'h03F0;   // 行 15 段10
        12'd491  : pix_seg = 16'h003F;   // 行 15 段11
        12'd492  : pix_seg = 16'h07E0;   // 行 15 段12
        12'd493  : pix_seg = 16'h007C;   // 行 15 段13
        12'd494  : pix_seg = 16'h1F80;   // 行 15 段14
        12'd495  : pix_seg = 16'h01F8;   // 行 15 段15
        12'd496  : pix_seg = 16'h3E00;   // 行 15 段16
        12'd497  : pix_seg = 16'h03E0;   // 行 15 段17
        12'd512  : pix_seg = 16'h0007;   // 行 16 段 0
        12'd513  : pix_seg = 16'hE000;   // 行 16 段 1
        12'd514  : pix_seg = 16'h7E0F;   // 行 16 段 2
        12'd515  : pix_seg = 16'h8001;   // 行 16 段 3
        12'd516  : pix_seg = 16'hF800;   // 行 16 段 4
        12'd517  : pix_seg = 16'h0FC0;   // 行 16 段 5
        12'd519  : pix_seg = 16'h0FC0;   // 行 16 段 7
        12'd522  : pix_seg = 16'h03F0;   // 行 16 段10
        12'd523  : pix_seg = 16'h003F;   // 行 16 段11
        12'd524  : pix_seg = 16'h07C0;   // 行 16 段12
        12'd525  : pix_seg = 16'h00FC;   // 行 16 段13
        12'd526  : pix_seg = 16'h1F80;   // 行 16 段14
        12'd527  : pix_seg = 16'h01F8;   // 行 16 段15
        12'd528  : pix_seg = 16'h3E00;   // 行 16 段16
        12'd544  : pix_seg = 16'h0003;   // 行 17 段 0
        12'd545  : pix_seg = 16'hC000;   // 行 17 段 1
        12'd546  : pix_seg = 16'h7E0F;   // 行 17 段 2
        12'd547  : pix_seg = 16'h8001;   // 行 17 段 3
        12'd548  : pix_seg = 16'hF800;   // 行 17 段 4
        12'd549  : pix_seg = 16'h0FC0;   // 行 17 段 5
        12'd551  : pix_seg = 16'h1FC0;   // 行 17 段 7
        12'd554  : pix_seg = 16'h01E0;   // 行 17 段10
        12'd555  : pix_seg = 16'h003F;   // 行 17 段11
        12'd556  : pix_seg = 16'h07C0;   // 行 17 段12
        12'd557  : pix_seg = 16'h00FC;   // 行 17 段13
        12'd558  : pix_seg = 16'h0F00;   // 行 17 段14
        12'd559  : pix_seg = 16'h01F8;   // 行 17 段15
        12'd560  : pix_seg = 16'h7E00;   // 行 17 段16
        12'd578  : pix_seg = 16'h7E1F;   // 行 18 段 2
        12'd579  : pix_seg = 16'h8001;   // 行 18 段 3
        12'd580  : pix_seg = 16'hF800;   // 行 18 段 4
        12'd581  : pix_seg = 16'h0FC0;   // 行 18 段 5
        12'd583  : pix_seg = 16'h1F80;   // 行 18 段 7
        12'd587  : pix_seg = 16'h003F;   // 行 18 段11
        12'd588  : pix_seg = 16'h0FC0;   // 行 18 段12
        12'd589  : pix_seg = 16'h00FC;   // 行 18 段13
        12'd591  : pix_seg = 16'h01F8;   // 行 18 段15
        12'd592  : pix_seg = 16'h7E00;   // 行 18 段16
        12'd610  : pix_seg = 16'hFC1F;   // 行 19 段 2
        12'd611  : pix_seg = 16'h8001;   // 行 19 段 3
        12'd612  : pix_seg = 16'hF800;   // 行 19 段 4
        12'd613  : pix_seg = 16'h0FC0;   // 行 19 段 5
        12'd615  : pix_seg = 16'h1F80;   // 行 19 段 7
        12'd619  : pix_seg = 16'h007E;   // 行 19 段11
        12'd620  : pix_seg = 16'h0FC0;   // 行 19 段12
        12'd621  : pix_seg = 16'h00FC;   // 行 19 段13
        12'd623  : pix_seg = 16'h03F0;   // 行 19 段15
        12'd624  : pix_seg = 16'h7E7F;   // 行 19 段16
        12'd625  : pix_seg = 16'hC000;   // 行 19 段17
        12'd642  : pix_seg = 16'hFC1F;   // 行 20 段 2
        12'd643  : pix_seg = 16'h8001;   // 行 20 段 3
        12'd644  : pix_seg = 16'hF800;   // 行 20 段 4
        12'd645  : pix_seg = 16'h0FC0;   // 行 20 段 5
        12'd647  : pix_seg = 16'h3F00;   // 行 20 段 7
        12'd651  : pix_seg = 16'h007E;   // 行 20 段11
        12'd652  : pix_seg = 16'h0FC0;   // 行 20 段12
        12'd653  : pix_seg = 16'h00FC;   // 行 20 段13
        12'd655  : pix_seg = 16'h03F0;   // 行 20 段15
        12'd656  : pix_seg = 16'h7FFF;   // 行 20 段16
        12'd657  : pix_seg = 16'hF800;   // 行 20 段17
        12'd673  : pix_seg = 16'h0001;   // 行 21 段 1
        12'd674  : pix_seg = 16'hF81F;   // 行 21 段 2
        12'd675  : pix_seg = 16'h8001;   // 行 21 段 3
        12'd676  : pix_seg = 16'hF800;   // 行 21 段 4
        12'd677  : pix_seg = 16'h0FC0;   // 行 21 段 5
        12'd679  : pix_seg = 16'h3F00;   // 行 21 段 7
        12'd683  : pix_seg = 16'h00FE;   // 行 21 段11
        12'd684  : pix_seg = 16'h0FC0;   // 行 21 段12
        12'd685  : pix_seg = 16'h00FC;   // 行 21 段13
        12'd687  : pix_seg = 16'h07E0;   // 行 21 段15
        12'd688  : pix_seg = 16'h7FFF;   // 行 21 段16
        12'd689  : pix_seg = 16'hFE00;   // 行 21 段17
        12'd705  : pix_seg = 16'h0003;   // 行 22 段 1
        12'd706  : pix_seg = 16'hF81F;   // 行 22 段 2
        12'd707  : pix_seg = 16'h8001;   // 行 22 段 3
        12'd708  : pix_seg = 16'hF800;   // 行 22 段 4
        12'd709  : pix_seg = 16'h0FC0;   // 行 22 段 5
        12'd711  : pix_seg = 16'h7E00;   // 行 22 段 7
        12'd712  : pix_seg = 16'h1FFF;   // 行 22 段 8
        12'd713  : pix_seg = 16'hFFFE;   // 行 22 段 9
        12'd715  : pix_seg = 16'h01FC;   // 行 22 段11
        12'd716  : pix_seg = 16'h0FC0;   // 行 22 段12
        12'd717  : pix_seg = 16'h00FC;   // 行 22 段13
        12'd719  : pix_seg = 16'h0FE0;   // 行 22 段15
        12'd720  : pix_seg = 16'h7FFF;   // 行 22 段16
        12'd721  : pix_seg = 16'hFF00;   // 行 22 段17
        12'd737  : pix_seg = 16'h0007;   // 行 23 段 1
        12'd738  : pix_seg = 16'hF01F;   // 行 23 段 2
        12'd739  : pix_seg = 16'h8001;   // 行 23 段 3
        12'd740  : pix_seg = 16'hF800;   // 行 23 段 4
        12'd741  : pix_seg = 16'h0FC0;   // 行 23 段 5
        12'd743  : pix_seg = 16'h7E00;   // 行 23 段 7
        12'd744  : pix_seg = 16'h1FFF;   // 行 23 段 8
        12'd745  : pix_seg = 16'hFFFE;   // 行 23 段 9
        12'd747  : pix_seg = 16'h03F8;   // 行 23 段11
        12'd748  : pix_seg = 16'h0FC0;   // 行 23 段12
        12'd749  : pix_seg = 16'h00FC;   // 行 23 段13
        12'd751  : pix_seg = 16'h1FC0;   // 行 23 段15
        12'd752  : pix_seg = 16'h7FFF;   // 行 23 段16
        12'd753  : pix_seg = 16'hFF80;   // 行 23 段17
        12'd769  : pix_seg = 16'h000F;   // 行 24 段 1
        12'd770  : pix_seg = 16'hE01F;   // 行 24 段 2
        12'd771  : pix_seg = 16'h8001;   // 行 24 段 3
        12'd772  : pix_seg = 16'hF800;   // 行 24 段 4
        12'd773  : pix_seg = 16'h0FC0;   // 行 24 段 5
        12'd775  : pix_seg = 16'hFC00;   // 行 24 段 7
        12'd776  : pix_seg = 16'h3FFF;   // 行 24 段 8
        12'd777  : pix_seg = 16'hFFFE;   // 行 24 段 9
        12'd779  : pix_seg = 16'h07F0;   // 行 24 段11
        12'd780  : pix_seg = 16'h0FC0;   // 行 24 段12
        12'd781  : pix_seg = 16'h00FC;   // 行 24 段13
        12'd783  : pix_seg = 16'h3F80;   // 行 24 段15
        12'd784  : pix_seg = 16'h7FE0;   // 行 24 段16
        12'd785  : pix_seg = 16'h7F80;   // 行 24 段17
        12'd801  : pix_seg = 16'h001F;   // 行 25 段 1
        12'd802  : pix_seg = 16'hC01F;   // 行 25 段 2
        12'd803  : pix_seg = 16'h8001;   // 行 25 段 3
        12'd804  : pix_seg = 16'hF800;   // 行 25 段 4
        12'd805  : pix_seg = 16'h0F80;   // 行 25 段 5
        12'd807  : pix_seg = 16'hFC00;   // 行 25 段 7
        12'd808  : pix_seg = 16'h3FFF;   // 行 25 段 8
        12'd809  : pix_seg = 16'hFFFE;   // 行 25 段 9
        12'd811  : pix_seg = 16'h0FE0;   // 行 25 段11
        12'd812  : pix_seg = 16'h0FC0;   // 行 25 段12
        12'd813  : pix_seg = 16'h00FC;   // 行 25 段13
        12'd815  : pix_seg = 16'h7F00;   // 行 25 段15
        12'd816  : pix_seg = 16'h7F80;   // 行 25 段16
        12'd817  : pix_seg = 16'h1FC0;   // 行 25 段17
        12'd833  : pix_seg = 16'h003F;   // 行 26 段 1
        12'd834  : pix_seg = 16'h801F;   // 行 26 段 2
        12'd835  : pix_seg = 16'h8001;   // 行 26 段 3
        12'd836  : pix_seg = 16'hF800;   // 行 26 段 4
        12'd837  : pix_seg = 16'h0F80;   // 行 26 段 5
        12'd838  : pix_seg = 16'h0001;   // 行 26 段 6
        12'd839  : pix_seg = 16'hF800;   // 行 26 段 7
        12'd843  : pix_seg = 16'h1FC0;   // 行 26 段11
        12'd844  : pix_seg = 16'h0FC0;   // 行 26 段12
        12'd845  : pix_seg = 16'h00FC;   // 行 26 段13
        12'd847  : pix_seg = 16'hFE00;   // 行 26 段15
        12'd848  : pix_seg = 16'h7F00;   // 行 26 段16
        12'd849  : pix_seg = 16'h0FC0;   // 行 26 段17
        12'd865  : pix_seg = 16'h007F;   // 行 27 段 1
        12'd866  : pix_seg = 16'h001F;   // 行 27 段 2
        12'd867  : pix_seg = 16'h8001;   // 行 27 段 3
        12'd868  : pix_seg = 16'hF000;   // 行 27 段 4
        12'd869  : pix_seg = 16'h0F80;   // 行 27 段 5
        12'd870  : pix_seg = 16'h0001;   // 行 27 段 6
        12'd871  : pix_seg = 16'hF800;   // 行 27 段 7
        12'd875  : pix_seg = 16'h3F80;   // 行 27 段11
        12'd876  : pix_seg = 16'h0FC0;   // 行 27 段12
        12'd877  : pix_seg = 16'h00F8;   // 行 27 段13
        12'd878  : pix_seg = 16'h0001;   // 行 27 段14
        12'd879  : pix_seg = 16'hFC00;   // 行 27 段15
        12'd880  : pix_seg = 16'h7E00;   // 行 27 段16
        12'd881  : pix_seg = 16'h0FC0;   // 行 27 段17
        12'd897  : pix_seg = 16'h00FE;   // 行 28 段 1
        12'd898  : pix_seg = 16'h001F;   // 行 28 段 2
        12'd899  : pix_seg = 16'h8001;   // 行 28 段 3
        12'd900  : pix_seg = 16'hF000;   // 行 28 段 4
        12'd901  : pix_seg = 16'h1F80;   // 行 28 段 5
        12'd902  : pix_seg = 16'h0003;   // 行 28 段 6
        12'd903  : pix_seg = 16'hF000;   // 行 28 段 7
        12'd907  : pix_seg = 16'h7F00;   // 行 28 段11
        12'd908  : pix_seg = 16'h0FC0;   // 行 28 段12
        12'd909  : pix_seg = 16'h00F8;   // 行 28 段13
        12'd910  : pix_seg = 16'h0003;   // 行 28 段14
        12'd911  : pix_seg = 16'hF800;   // 行 28 段15
        12'd912  : pix_seg = 16'h7E00;   // 行 28 段16
        12'd913  : pix_seg = 16'h0FC0;   // 行 28 段17
        12'd929  : pix_seg = 16'h01FC;   // 行 29 段 1
        12'd930  : pix_seg = 16'h001F;   // 行 29 段 2
        12'd931  : pix_seg = 16'h0003;   // 行 29 段 3
        12'd932  : pix_seg = 16'hF000;   // 行 29 段 4
        12'd933  : pix_seg = 16'h1F80;   // 行 29 段 5
        12'd934  : pix_seg = 16'h0003;   // 行 29 段 6
        12'd935  : pix_seg = 16'hF000;   // 行 29 段 7
        12'd939  : pix_seg = 16'hFE00;   // 行 29 段11
        12'd940  : pix_seg = 16'h0F80;   // 行 29 段12
        12'd941  : pix_seg = 16'h01F8;   // 行 29 段13
        12'd942  : pix_seg = 16'h0007;   // 行 29 段14
        12'd943  : pix_seg = 16'hF000;   // 行 29 段15
        12'd944  : pix_seg = 16'h7C00;   // 行 29 段16
        12'd945  : pix_seg = 16'h0FC0;   // 行 29 段17
        12'd961  : pix_seg = 16'h03F8;   // 行 30 段 1
        12'd962  : pix_seg = 16'h001F;   // 行 30 段 2
        12'd963  : pix_seg = 16'h0003;   // 行 30 段 3
        12'd964  : pix_seg = 16'hF000;   // 行 30 段 4
        12'd965  : pix_seg = 16'h1F80;   // 行 30 段 5
        12'd966  : pix_seg = 16'h0007;   // 行 30 段 6
        12'd967  : pix_seg = 16'hF000;   // 行 30 段 7
        12'd970  : pix_seg = 16'h0001;   // 行 30 段10
        12'd971  : pix_seg = 16'hFC00;   // 行 30 段11
        12'd972  : pix_seg = 16'h0F80;   // 行 30 段12
        12'd973  : pix_seg = 16'h01F8;   // 行 30 段13
        12'd974  : pix_seg = 16'h000F;   // 行 30 段14
        12'd975  : pix_seg = 16'hE000;   // 行 30 段15
        12'd976  : pix_seg = 16'h7C00;   // 行 30 段16
        12'd977  : pix_seg = 16'h0FC0;   // 行 30 段17
        12'd993  : pix_seg = 16'h07F0;   // 行 31 段 1
        12'd994  : pix_seg = 16'h003F;   // 行 31 段 2
        12'd995  : pix_seg = 16'h0003;   // 行 31 段 3
        12'd996  : pix_seg = 16'hF000;   // 行 31 段 4
        12'd997  : pix_seg = 16'h1F80;   // 行 31 段 5
        12'd998  : pix_seg = 16'h0007;   // 行 31 段 6
        12'd999  : pix_seg = 16'hE000;   // 行 31 段 7
        12'd1002 : pix_seg = 16'h0003;   // 行 31 段10
        12'd1003 : pix_seg = 16'hF800;   // 行 31 段11
        12'd1004 : pix_seg = 16'h0F80;   // 行 31 段12
        12'd1005 : pix_seg = 16'h01F8;   // 行 31 段13
        12'd1006 : pix_seg = 16'h001F;   // 行 31 段14
        12'd1007 : pix_seg = 16'hC000;   // 行 31 段15
        12'd1008 : pix_seg = 16'hFC00;   // 行 31 段16
        12'd1009 : pix_seg = 16'h0FC0;   // 行 31 段17
        12'd1025 : pix_seg = 16'h0FE0;   // 行 32 段 1
        12'd1026 : pix_seg = 16'h003F;   // 行 32 段 2
        12'd1027 : pix_seg = 16'h0003;   // 行 32 段 3
        12'd1028 : pix_seg = 16'hF000;   // 行 32 段 4
        12'd1029 : pix_seg = 16'h1F80;   // 行 32 段 5
        12'd1030 : pix_seg = 16'h0007;   // 行 32 段 6
        12'd1031 : pix_seg = 16'hE000;   // 行 32 段 7
        12'd1034 : pix_seg = 16'h0007;   // 行 32 段10
        12'd1035 : pix_seg = 16'hF000;   // 行 32 段11
        12'd1036 : pix_seg = 16'h1F80;   // 行 32 段12
        12'd1037 : pix_seg = 16'h01F8;   // 行 32 段13
        12'd1038 : pix_seg = 16'h003F;   // 行 32 段14
        12'd1039 : pix_seg = 16'h8000;   // 行 32 段15
        12'd1040 : pix_seg = 16'hFC00;   // 行 32 段16
        12'd1041 : pix_seg = 16'h0FC0;   // 行 32 段17
        12'd1057 : pix_seg = 16'h1FC0;   // 行 33 段 1
        12'd1058 : pix_seg = 16'h003F;   // 行 33 段 2
        12'd1059 : pix_seg = 16'h0003;   // 行 33 段 3
        12'd1060 : pix_seg = 16'hF000;   // 行 33 段 4
        12'd1061 : pix_seg = 16'h1F80;   // 行 33 段 5
        12'd1062 : pix_seg = 16'h000F;   // 行 33 段 6
        12'd1063 : pix_seg = 16'hC000;   // 行 33 段 7
        12'd1066 : pix_seg = 16'h000F;   // 行 33 段10
        12'd1067 : pix_seg = 16'hE000;   // 行 33 段11
        12'd1068 : pix_seg = 16'h1F80;   // 行 33 段12
        12'd1069 : pix_seg = 16'h01F8;   // 行 33 段13
        12'd1070 : pix_seg = 16'h007F;   // 行 33 段14
        12'd1072 : pix_seg = 16'hFC00;   // 行 33 段16
        12'd1073 : pix_seg = 16'h0FC0;   // 行 33 段17
        12'd1089 : pix_seg = 16'h3F80;   // 行 34 段 1
        12'd1090 : pix_seg = 16'h003F;   // 行 34 段 2
        12'd1091 : pix_seg = 16'h0003;   // 行 34 段 3
        12'd1092 : pix_seg = 16'hF000;   // 行 34 段 4
        12'd1093 : pix_seg = 16'h1F80;   // 行 34 段 5
        12'd1094 : pix_seg = 16'h000F;   // 行 34 段 6
        12'd1095 : pix_seg = 16'hC000;   // 行 34 段 7
        12'd1098 : pix_seg = 16'h001F;   // 行 34 段10
        12'd1099 : pix_seg = 16'hC000;   // 行 34 段11
        12'd1100 : pix_seg = 16'h1F80;   // 行 34 段12
        12'd1101 : pix_seg = 16'h01F8;   // 行 34 段13
        12'd1102 : pix_seg = 16'h00FE;   // 行 34 段14
        12'd1104 : pix_seg = 16'hFC00;   // 行 34 段16
        12'd1105 : pix_seg = 16'h0FC0;   // 行 34 段17
        12'd1121 : pix_seg = 16'h7F00;   // 行 35 段 1
        12'd1122 : pix_seg = 16'h003F;   // 行 35 段 2
        12'd1123 : pix_seg = 16'h0003;   // 行 35 段 3
        12'd1124 : pix_seg = 16'hF000;   // 行 35 段 4
        12'd1125 : pix_seg = 16'h1F80;   // 行 35 段 5
        12'd1126 : pix_seg = 16'h001F;   // 行 35 段 6
        12'd1127 : pix_seg = 16'h8000;   // 行 35 段 7
        12'd1130 : pix_seg = 16'h003F;   // 行 35 段10
        12'd1131 : pix_seg = 16'h8000;   // 行 35 段11
        12'd1132 : pix_seg = 16'h1F80;   // 行 35 段12
        12'd1133 : pix_seg = 16'h01F8;   // 行 35 段13
        12'd1134 : pix_seg = 16'h01FC;   // 行 35 段14
        12'd1136 : pix_seg = 16'hFC00;   // 行 35 段16
        12'd1137 : pix_seg = 16'h0FC0;   // 行 35 段17
        12'd1153 : pix_seg = 16'hFE00;   // 行 36 段 1
        12'd1154 : pix_seg = 16'h003F;   // 行 36 段 2
        12'd1155 : pix_seg = 16'h0003;   // 行 36 段 3
        12'd1156 : pix_seg = 16'hF000;   // 行 36 段 4
        12'd1157 : pix_seg = 16'h1F80;   // 行 36 段 5
        12'd1158 : pix_seg = 16'h001F;   // 行 36 段 6
        12'd1159 : pix_seg = 16'h8000;   // 行 36 段 7
        12'd1162 : pix_seg = 16'h007F;   // 行 36 段10
        12'd1164 : pix_seg = 16'h1F80;   // 行 36 段12
        12'd1165 : pix_seg = 16'h01F8;   // 行 36 段13
        12'd1166 : pix_seg = 16'h03F8;   // 行 36 段14
        12'd1168 : pix_seg = 16'hFC00;   // 行 36 段16
        12'd1169 : pix_seg = 16'h0FC0;   // 行 36 段17
        12'd1184 : pix_seg = 16'h0001;   // 行 37 段 0
        12'd1185 : pix_seg = 16'hFC00;   // 行 37 段 1
        12'd1186 : pix_seg = 16'h003F;   // 行 37 段 2
        12'd1187 : pix_seg = 16'h0007;   // 行 37 段 3
        12'd1188 : pix_seg = 16'hF000;   // 行 37 段 4
        12'd1189 : pix_seg = 16'h1F80;   // 行 37 段 5
        12'd1190 : pix_seg = 16'h003F;   // 行 37 段 6
        12'd1194 : pix_seg = 16'h00FE;   // 行 37 段10
        12'd1196 : pix_seg = 16'h1F80;   // 行 37 段12
        12'd1197 : pix_seg = 16'h01F8;   // 行 37 段13
        12'd1198 : pix_seg = 16'h07F0;   // 行 37 段14
        12'd1200 : pix_seg = 16'hFC00;   // 行 37 段16
        12'd1201 : pix_seg = 16'h1F80;   // 行 37 段17
        12'd1216 : pix_seg = 16'h0003;   // 行 38 段 0
        12'd1217 : pix_seg = 16'hF800;   // 行 38 段 1
        12'd1218 : pix_seg = 16'h003F;   // 行 38 段 2
        12'd1219 : pix_seg = 16'h8007;   // 行 38 段 3
        12'd1220 : pix_seg = 16'hE000;   // 行 38 段 4
        12'd1221 : pix_seg = 16'h1F80;   // 行 38 段 5
        12'd1222 : pix_seg = 16'h003F;   // 行 38 段 6
        12'd1226 : pix_seg = 16'h01FC;   // 行 38 段10
        12'd1228 : pix_seg = 16'h1FC0;   // 行 38 段12
        12'd1229 : pix_seg = 16'h03F0;   // 行 38 段13
        12'd1230 : pix_seg = 16'h0FE0;   // 行 38 段14
        12'd1232 : pix_seg = 16'hFE00;   // 行 38 段16
        12'd1233 : pix_seg = 16'h1F80;   // 行 38 段17
        12'd1248 : pix_seg = 16'h0007;   // 行 39 段 0
        12'd1249 : pix_seg = 16'hF000;   // 行 39 段 1
        12'd1250 : pix_seg = 16'h001F;   // 行 39 段 2
        12'd1251 : pix_seg = 16'hC00F;   // 行 39 段 3
        12'd1252 : pix_seg = 16'hE000;   // 行 39 段 4
        12'd1253 : pix_seg = 16'h1F00;   // 行 39 段 5
        12'd1254 : pix_seg = 16'h007E;   // 行 39 段 6
        12'd1258 : pix_seg = 16'h03F8;   // 行 39 段10
        12'd1260 : pix_seg = 16'h0FE0;   // 行 39 段12
        12'd1261 : pix_seg = 16'h07F0;   // 行 39 段13
        12'd1262 : pix_seg = 16'h1FC0;   // 行 39 段14
        12'd1264 : pix_seg = 16'h7F00;   // 行 39 段16
        12'd1265 : pix_seg = 16'h3F80;   // 行 39 段17
        12'd1280 : pix_seg = 16'h000F;   // 行 40 段 0
        12'd1281 : pix_seg = 16'hE000;   // 行 40 段 1
        12'd1282 : pix_seg = 16'h001F;   // 行 40 段 2
        12'd1283 : pix_seg = 16'hE03F;   // 行 40 段 3
        12'd1284 : pix_seg = 16'hC000;   // 行 40 段 4
        12'd1285 : pix_seg = 16'h1F00;   // 行 40 段 5
        12'd1286 : pix_seg = 16'h007E;   // 行 40 段 6
        12'd1290 : pix_seg = 16'h07F0;   // 行 40 段10
        12'd1292 : pix_seg = 16'h0FF0;   // 行 40 段12
        12'd1293 : pix_seg = 16'h1FE0;   // 行 40 段13
        12'd1294 : pix_seg = 16'h3F80;   // 行 40 段14
        12'd1296 : pix_seg = 16'h7F80;   // 行 40 段16
        12'd1297 : pix_seg = 16'hFF00;   // 行 40 段17
        12'd1312 : pix_seg = 16'h001F;   // 行 41 段 0
        12'd1313 : pix_seg = 16'hFFFF;   // 行 41 段 1
        12'd1314 : pix_seg = 16'hF80F;   // 行 41 段 2
        12'd1315 : pix_seg = 16'hFFFF;   // 行 41 段 3
        12'd1316 : pix_seg = 16'h8000;   // 行 41 段 4
        12'd1317 : pix_seg = 16'h3F00;   // 行 41 段 5
        12'd1318 : pix_seg = 16'h00FE;   // 行 41 段 6
        12'd1322 : pix_seg = 16'h0FFF;   // 行 41 段10
        12'd1323 : pix_seg = 16'hFFFC;   // 行 41 段11
        12'd1324 : pix_seg = 16'h07FF;   // 行 41 段12
        12'd1325 : pix_seg = 16'hFFC0;   // 行 41 段13
        12'd1326 : pix_seg = 16'h7FFF;   // 行 41 段14
        12'd1327 : pix_seg = 16'hFFE0;   // 行 41 段15
        12'd1328 : pix_seg = 16'h3FFF;   // 行 41 段16
        12'd1329 : pix_seg = 16'hFE00;   // 行 41 段17
        12'd1344 : pix_seg = 16'h001F;   // 行 42 段 0
        12'd1345 : pix_seg = 16'hFFFF;   // 行 42 段 1
        12'd1346 : pix_seg = 16'hF807;   // 行 42 段 2
        12'd1347 : pix_seg = 16'hFFFF;   // 行 42 段 3
        12'd1349 : pix_seg = 16'h3F00;   // 行 42 段 5
        12'd1350 : pix_seg = 16'h00FC;   // 行 42 段 6
        12'd1354 : pix_seg = 16'h0FFF;   // 行 42 段10
        12'd1355 : pix_seg = 16'hFFFC;   // 行 42 段11
        12'd1356 : pix_seg = 16'h03FF;   // 行 42 段12
        12'd1357 : pix_seg = 16'hFF80;   // 行 42 段13
        12'd1358 : pix_seg = 16'h7FFF;   // 行 42 段14
        12'd1359 : pix_seg = 16'hFFE0;   // 行 42 段15
        12'd1360 : pix_seg = 16'h1FFF;   // 行 42 段16
        12'd1361 : pix_seg = 16'hFC00;   // 行 42 段17
        12'd1861 : pix_seg = 16'h001F;   // 行 58 段 5
        12'd1862 : pix_seg = 16'h8000;   // 行 58 段 6
        12'd1865 : pix_seg = 16'h7F00;   // 行 58 段 9
        12'd1867 : pix_seg = 16'h07FF;   // 行 58 段11
        12'd1868 : pix_seg = 16'hFFFF;   // 行 58 段12
        12'd1869 : pix_seg = 16'hFFFF;   // 行 58 段13
        12'd1870 : pix_seg = 16'hF000;   // 行 58 段14
        12'd1871 : pix_seg = 16'h7F00;   // 行 58 段15
        12'd1888 : pix_seg = 16'h0007;   // 行 59 段 0
        12'd1889 : pix_seg = 16'hFFFF;   // 行 59 段 1
        12'd1890 : pix_seg = 16'hFFFF;   // 行 59 段 2
        12'd1891 : pix_seg = 16'hFFFC;   // 行 59 段 3
        12'd1893 : pix_seg = 16'h001F;   // 行 59 段 5
        12'd1894 : pix_seg = 16'h8000;   // 行 59 段 6
        12'd1897 : pix_seg = 16'h7F00;   // 行 59 段 9
        12'd1899 : pix_seg = 16'h07FF;   // 行 59 段11
        12'd1900 : pix_seg = 16'hFFFF;   // 行 59 段12
        12'd1901 : pix_seg = 16'hFFFF;   // 行 59 段13
        12'd1902 : pix_seg = 16'hF000;   // 行 59 段14
        12'd1903 : pix_seg = 16'h7E00;   // 行 59 段15
        12'd1920 : pix_seg = 16'h0007;   // 行 60 段 0
        12'd1921 : pix_seg = 16'hFFFF;   // 行 60 段 1
        12'd1922 : pix_seg = 16'hFFFF;   // 行 60 段 2
        12'd1923 : pix_seg = 16'hFFFC;   // 行 60 段 3
        12'd1925 : pix_seg = 16'h001F;   // 行 60 段 5
        12'd1926 : pix_seg = 16'h8000;   // 行 60 段 6
        12'd1929 : pix_seg = 16'h7F00;   // 行 60 段 9
        12'd1931 : pix_seg = 16'h07FF;   // 行 60 段11
        12'd1932 : pix_seg = 16'hFFFF;   // 行 60 段12
        12'd1933 : pix_seg = 16'hFFFF;   // 行 60 段13
        12'd1934 : pix_seg = 16'hF000;   // 行 60 段14
        12'd1935 : pix_seg = 16'hFE00;   // 行 60 段15
        12'd1952 : pix_seg = 16'h0007;   // 行 61 段 0
        12'd1953 : pix_seg = 16'hFFFF;   // 行 61 段 1
        12'd1954 : pix_seg = 16'hFFFF;   // 行 61 段 2
        12'd1955 : pix_seg = 16'hFFFC;   // 行 61 段 3
        12'd1956 : pix_seg = 16'h03FF;   // 行 61 段 4
        12'd1957 : pix_seg = 16'hFFFF;   // 行 61 段 5
        12'd1958 : pix_seg = 16'hFFFF;   // 行 61 段 6
        12'd1959 : pix_seg = 16'hFC00;   // 行 61 段 7
        12'd1961 : pix_seg = 16'h7F00;   // 行 61 段 9
        12'd1963 : pix_seg = 16'h07FF;   // 行 61 段11
        12'd1964 : pix_seg = 16'hFFFF;   // 行 61 段12
        12'd1965 : pix_seg = 16'hFFFF;   // 行 61 段13
        12'd1966 : pix_seg = 16'hF000;   // 行 61 段14
        12'd1967 : pix_seg = 16'hFC00;   // 行 61 段15
        12'd1984 : pix_seg = 16'h0007;   // 行 62 段 0
        12'd1985 : pix_seg = 16'hFFFF;   // 行 62 段 1
        12'd1986 : pix_seg = 16'hFFFF;   // 行 62 段 2
        12'd1987 : pix_seg = 16'hFFFC;   // 行 62 段 3
        12'd1988 : pix_seg = 16'h03FF;   // 行 62 段 4
        12'd1989 : pix_seg = 16'hFFFF;   // 行 62 段 5
        12'd1990 : pix_seg = 16'hFFFF;   // 行 62 段 6
        12'd1991 : pix_seg = 16'hFC00;   // 行 62 段 7
        12'd1993 : pix_seg = 16'h7F00;   // 行 62 段 9
        12'd1995 : pix_seg = 16'h07FF;   // 行 62 段11
        12'd1996 : pix_seg = 16'hFFFF;   // 行 62 段12
        12'd1997 : pix_seg = 16'hFFFF;   // 行 62 段13
        12'd1998 : pix_seg = 16'hF001;   // 行 62 段14
        12'd1999 : pix_seg = 16'hFFFF;   // 行 62 段15
        12'd2000 : pix_seg = 16'hFFFF;   // 行 62 段16
        12'd2001 : pix_seg = 16'hFFE0;   // 行 62 段17
        12'd2016 : pix_seg = 16'h0007;   // 行 63 段 0
        12'd2017 : pix_seg = 16'hFFFF;   // 行 63 段 1
        12'd2018 : pix_seg = 16'hFFFF;   // 行 63 段 2
        12'd2019 : pix_seg = 16'hFFFC;   // 行 63 段 3
        12'd2020 : pix_seg = 16'h03FF;   // 行 63 段 4
        12'd2021 : pix_seg = 16'hFFFF;   // 行 63 段 5
        12'd2022 : pix_seg = 16'hFFFF;   // 行 63 段 6
        12'd2023 : pix_seg = 16'hFC00;   // 行 63 段 7
        12'd2025 : pix_seg = 16'h7F00;   // 行 63 段 9
        12'd2027 : pix_seg = 16'h07FF;   // 行 63 段11
        12'd2028 : pix_seg = 16'hFFFF;   // 行 63 段12
        12'd2029 : pix_seg = 16'hFFFF;   // 行 63 段13
        12'd2030 : pix_seg = 16'hF001;   // 行 63 段14
        12'd2031 : pix_seg = 16'hFFFF;   // 行 63 段15
        12'd2032 : pix_seg = 16'hFFFF;   // 行 63 段16
        12'd2033 : pix_seg = 16'hFFE0;   // 行 63 段17
        12'd2048 : pix_seg = 16'h0007;   // 行 64 段 0
        12'd2049 : pix_seg = 16'hFFFF;   // 行 64 段 1
        12'd2050 : pix_seg = 16'hFFFF;   // 行 64 段 2
        12'd2051 : pix_seg = 16'hFFFC;   // 行 64 段 3
        12'd2052 : pix_seg = 16'h03FF;   // 行 64 段 4
        12'd2053 : pix_seg = 16'hFFFF;   // 行 64 段 5
        12'd2054 : pix_seg = 16'hFFFF;   // 行 64 段 6
        12'd2055 : pix_seg = 16'hF800;   // 行 64 段 7
        12'd2057 : pix_seg = 16'h7F00;   // 行 64 段 9
        12'd2059 : pix_seg = 16'h07F0;   // 行 64 段11
        12'd2061 : pix_seg = 16'h0007;   // 行 64 段13
        12'd2062 : pix_seg = 16'hF001;   // 行 64 段14
        12'd2063 : pix_seg = 16'hFFFF;   // 行 64 段15
        12'd2064 : pix_seg = 16'hFFFF;   // 行 64 段16
        12'd2065 : pix_seg = 16'hFFE0;   // 行 64 段17
        12'd2080 : pix_seg = 16'h0007;   // 行 65 段 0
        12'd2081 : pix_seg = 16'hE000;   // 行 65 段 1
        12'd2083 : pix_seg = 16'h00FC;   // 行 65 段 3
        12'd2084 : pix_seg = 16'h03FF;   // 行 65 段 4
        12'd2085 : pix_seg = 16'hFFFF;   // 行 65 段 5
        12'd2086 : pix_seg = 16'hFFFF;   // 行 65 段 6
        12'd2087 : pix_seg = 16'hF800;   // 行 65 段 7
        12'd2089 : pix_seg = 16'h7F00;   // 行 65 段 9
        12'd2091 : pix_seg = 16'h07F0;   // 行 65 段11
        12'd2092 : pix_seg = 16'h003F;   // 行 65 段12
        12'd2093 : pix_seg = 16'h0007;   // 行 65 段13
        12'd2094 : pix_seg = 16'hF003;   // 行 65 段14
        12'd2095 : pix_seg = 16'hFFFF;   // 行 65 段15
        12'd2096 : pix_seg = 16'hFFFF;   // 行 65 段16
        12'd2097 : pix_seg = 16'hFFC0;   // 行 65 段17
        12'd2112 : pix_seg = 16'h000F;   // 行 66 段 0
        12'd2113 : pix_seg = 16'hE000;   // 行 66 段 1
        12'd2115 : pix_seg = 16'h00FC;   // 行 66 段 3
        12'd2116 : pix_seg = 16'h03F0;   // 行 66 段 4
        12'd2118 : pix_seg = 16'h0001;   // 行 66 段 6
        12'd2119 : pix_seg = 16'hF800;   // 行 66 段 7
        12'd2121 : pix_seg = 16'h7F00;   // 行 66 段 9
        12'd2123 : pix_seg = 16'h07F0;   // 行 66 段11
        12'd2124 : pix_seg = 16'h003F;   // 行 66 段12
        12'd2125 : pix_seg = 16'h0007;   // 行 66 段13
        12'd2126 : pix_seg = 16'hF003;   // 行 66 段14
        12'd2127 : pix_seg = 16'hFFFF;   // 行 66 段15
        12'd2128 : pix_seg = 16'hFFFF;   // 行 66 段16
        12'd2129 : pix_seg = 16'hFFC0;   // 行 66 段17
        12'd2144 : pix_seg = 16'h000F;   // 行 67 段 0
        12'd2145 : pix_seg = 16'hE000;   // 行 67 段 1
        12'd2147 : pix_seg = 16'h01FC;   // 行 67 段 3
        12'd2148 : pix_seg = 16'h03E0;   // 行 67 段 4
        12'd2149 : pix_seg = 16'h1F00;   // 行 67 段 5
        12'd2150 : pix_seg = 16'h1F01;   // 行 67 段 6
        12'd2151 : pix_seg = 16'hF800;   // 行 67 段 7
        12'd2153 : pix_seg = 16'h7F00;   // 行 67 段 9
        12'd2155 : pix_seg = 16'h07F0;   // 行 67 段11
        12'd2156 : pix_seg = 16'h007F;   // 行 67 段12
        12'd2157 : pix_seg = 16'h0007;   // 行 67 段13
        12'd2158 : pix_seg = 16'hF003;   // 行 67 段14
        12'd2159 : pix_seg = 16'hFFFF;   // 行 67 段15
        12'd2160 : pix_seg = 16'hFFFF;   // 行 67 段16
        12'd2161 : pix_seg = 16'hFFC0;   // 行 67 段17
        12'd2176 : pix_seg = 16'h000F;   // 行 68 段 0
        12'd2177 : pix_seg = 16'hE3FF;   // 行 68 段 1
        12'd2178 : pix_seg = 16'hFFFF;   // 行 68 段 2
        12'd2179 : pix_seg = 16'hF1FC;   // 行 68 段 3
        12'd2180 : pix_seg = 16'h03E0;   // 行 68 段 4
        12'd2181 : pix_seg = 16'h3F00;   // 行 68 段 5
        12'd2182 : pix_seg = 16'h3F81;   // 行 68 段 6
        12'd2183 : pix_seg = 16'hF800;   // 行 68 段 7
        12'd2185 : pix_seg = 16'h7F00;   // 行 68 段 9
        12'd2187 : pix_seg = 16'h07F0;   // 行 68 段11
        12'd2188 : pix_seg = 16'h007F;   // 行 68 段12
        12'd2189 : pix_seg = 16'h0007;   // 行 68 段13
        12'd2190 : pix_seg = 16'hF007;   // 行 68 段14
        12'd2191 : pix_seg = 16'hF000;   // 行 68 段15
        12'd2192 : pix_seg = 16'h3F80;   // 行 68 段16
        12'd2208 : pix_seg = 16'h000F;   // 行 69 段 0
        12'd2209 : pix_seg = 16'hE3FF;   // 行 69 段 1
        12'd2210 : pix_seg = 16'hFFFF;   // 行 69 段 2
        12'd2211 : pix_seg = 16'hF1FC;   // 行 69 段 3
        12'd2212 : pix_seg = 16'h01FF;   // 行 69 段 4
        12'd2213 : pix_seg = 16'hFFFF;   // 行 69 段 5
        12'd2214 : pix_seg = 16'hFFFF;   // 行 69 段 6
        12'd2215 : pix_seg = 16'hF000;   // 行 69 段 7
        12'd2217 : pix_seg = 16'h7F00;   // 行 69 段 9
        12'd2219 : pix_seg = 16'h07F0;   // 行 69 段11
        12'd2220 : pix_seg = 16'h007F;   // 行 69 段12
        12'd2221 : pix_seg = 16'h0007;   // 行 69 段13
        12'd2222 : pix_seg = 16'hF007;   // 行 69 段14
        12'd2223 : pix_seg = 16'hE000;   // 行 69 段15
        12'd2224 : pix_seg = 16'h3F00;   // 行 69 段16
        12'd2240 : pix_seg = 16'h000F;   // 行 70 段 0
        12'd2241 : pix_seg = 16'hE3FF;   // 行 70 段 1
        12'd2242 : pix_seg = 16'hFFFF;   // 行 70 段 2
        12'd2243 : pix_seg = 16'hF1FC;   // 行 70 段 3
        12'd2244 : pix_seg = 16'h01FF;   // 行 70 段 4
        12'd2245 : pix_seg = 16'hFFFF;   // 行 70 段 5
        12'd2246 : pix_seg = 16'hFFFF;   // 行 70 段 6
        12'd2247 : pix_seg = 16'hF000;   // 行 70 段 7
        12'd2249 : pix_seg = 16'h7F00;   // 行 70 段 9
        12'd2251 : pix_seg = 16'h07F1;   // 行 70 段11
        12'd2252 : pix_seg = 16'hFFFF;   // 行 70 段12
        12'd2253 : pix_seg = 16'hFFC7;   // 行 70 段13
        12'd2254 : pix_seg = 16'hF007;   // 行 70 段14
        12'd2255 : pix_seg = 16'hE000;   // 行 70 段15
        12'd2256 : pix_seg = 16'h3F00;   // 行 70 段16
        12'd2272 : pix_seg = 16'h000F;   // 行 71 段 0
        12'd2273 : pix_seg = 16'hE3FF;   // 行 71 段 1
        12'd2274 : pix_seg = 16'hFFFF;   // 行 71 段 2
        12'd2275 : pix_seg = 16'hE1FC;   // 行 71 段 3
        12'd2276 : pix_seg = 16'h01FF;   // 行 71 段 4
        12'd2277 : pix_seg = 16'hFFFF;   // 行 71 段 5
        12'd2278 : pix_seg = 16'hFFFF;   // 行 71 段 6
        12'd2279 : pix_seg = 16'hE000;   // 行 71 段 7
        12'd2281 : pix_seg = 16'h7F00;   // 行 71 段 9
        12'd2283 : pix_seg = 16'h07F0;   // 行 71 段11
        12'd2284 : pix_seg = 16'hFFFF;   // 行 71 段12
        12'd2285 : pix_seg = 16'hFF87;   // 行 71 段13
        12'd2286 : pix_seg = 16'hE00F;   // 行 71 段14
        12'd2287 : pix_seg = 16'hC000;   // 行 71 段15
        12'd2288 : pix_seg = 16'h3F00;   // 行 71 段16
        12'd2304 : pix_seg = 16'h000F;   // 行 72 段 0
        12'd2305 : pix_seg = 16'hC3FF;   // 行 72 段 1
        12'd2306 : pix_seg = 16'hFFFF;   // 行 72 段 2
        12'd2307 : pix_seg = 16'hE1FC;   // 行 72 段 3
        12'd2308 : pix_seg = 16'h01FF;   // 行 72 段 4
        12'd2309 : pix_seg = 16'hFFFF;   // 行 72 段 5
        12'd2310 : pix_seg = 16'hFFFF;   // 行 72 段 6
        12'd2311 : pix_seg = 16'hE000;   // 行 72 段 7
        12'd2313 : pix_seg = 16'hFE00;   // 行 72 段 9
        12'd2315 : pix_seg = 16'h07E0;   // 行 72 段11
        12'd2316 : pix_seg = 16'hFFFF;   // 行 72 段12
        12'd2317 : pix_seg = 16'hFF8F;   // 行 72 段13
        12'd2318 : pix_seg = 16'hE00F;   // 行 72 段14
        12'd2319 : pix_seg = 16'hC000;   // 行 72 段15
        12'd2320 : pix_seg = 16'h7F00;   // 行 72 段16
        12'd2336 : pix_seg = 16'h000F;   // 行 73 段 0
        12'd2337 : pix_seg = 16'hC1FF;   // 行 73 段 1
        12'd2338 : pix_seg = 16'hFFFF;   // 行 73 段 2
        12'd2339 : pix_seg = 16'hE1FC;   // 行 73 段 3
        12'd2340 : pix_seg = 16'h00FF;   // 行 73 段 4
        12'd2341 : pix_seg = 16'hFFFF;   // 行 73 段 5
        12'd2342 : pix_seg = 16'hFFFF;   // 行 73 段 6
        12'd2343 : pix_seg = 16'hE000;   // 行 73 段 7
        12'd2345 : pix_seg = 16'hFE00;   // 行 73 段 9
        12'd2347 : pix_seg = 16'h0FE0;   // 行 73 段11
        12'd2348 : pix_seg = 16'hFFFF;   // 行 73 段12
        12'd2349 : pix_seg = 16'hFF8F;   // 行 73 段13
        12'd2350 : pix_seg = 16'hE01F;   // 行 73 段14
        12'd2351 : pix_seg = 16'h8000;   // 行 73 段15
        12'd2352 : pix_seg = 16'h7F00;   // 行 73 段16
        12'd2368 : pix_seg = 16'h000F;   // 行 74 段 0
        12'd2369 : pix_seg = 16'hC000;   // 行 74 段 1
        12'd2370 : pix_seg = 16'h3F00;   // 行 74 段 2
        12'd2371 : pix_seg = 16'h01F8;   // 行 74 段 3
        12'd2373 : pix_seg = 16'h7F00;   // 行 74 段 5
        12'd2374 : pix_seg = 16'h3F80;   // 行 74 段 6
        12'd2377 : pix_seg = 16'hFE00;   // 行 74 段 9
        12'd2379 : pix_seg = 16'h0FE0;   // 行 74 段11
        12'd2380 : pix_seg = 16'hFFFF;   // 行 74 段12
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
